gumstix/PKG900000001464/README.md

# Gumstix Raspberry Pi CM4 UprevAI
## PKG900000001464 

The **Gumstix Raspberry Pi CM4 UprevAI** replaces the CM3 compute module on compatible carrier boards, adding a CM4 connector and Google Coral TPU chip.
Accelerate your hardware and migrate it into the field of **Edge AI** without revising your design.

__Features Include__:
* Raspberry Pi CM3 compatible SODIMM edge connection
* Power indicator LED
* Google Coral G313-06329-00 TPU

__Links:__
* [AutoDoc Datasheet][autodoc]
* [Specifications][spec]
* [Store Page][store]
* [Schematics and Layout][hardware]

[thumbnail]: https://d3iwea566ns1n1.cloudfront.net/images/product/40edad650346ab020427c20a98565f45689e575a.png
[autodoc]: PKG900000001464_AutoDoc.pdf
[spec]: PKG900000001464_SpecSheet.pdf
[store]: https://store.gumstix.com/cm4-uprev-ai/
[hardware]: hardware/hardware.md
[firmware]: firmware/firmware.md
