gumstix/PKG900000001464/hardware/hardware.md

# Hardware

[Schematic PDF][pdf]
EAGLE [Schematic][sch] and [Layout][brd]

[pdf]: PKG900000001464.pdf
[brd]: PKG900000001464.brd
[sch]: PKG900000001464.sch
