gumstix/PKG900000001464/hardware/PKG900000001464.pdf

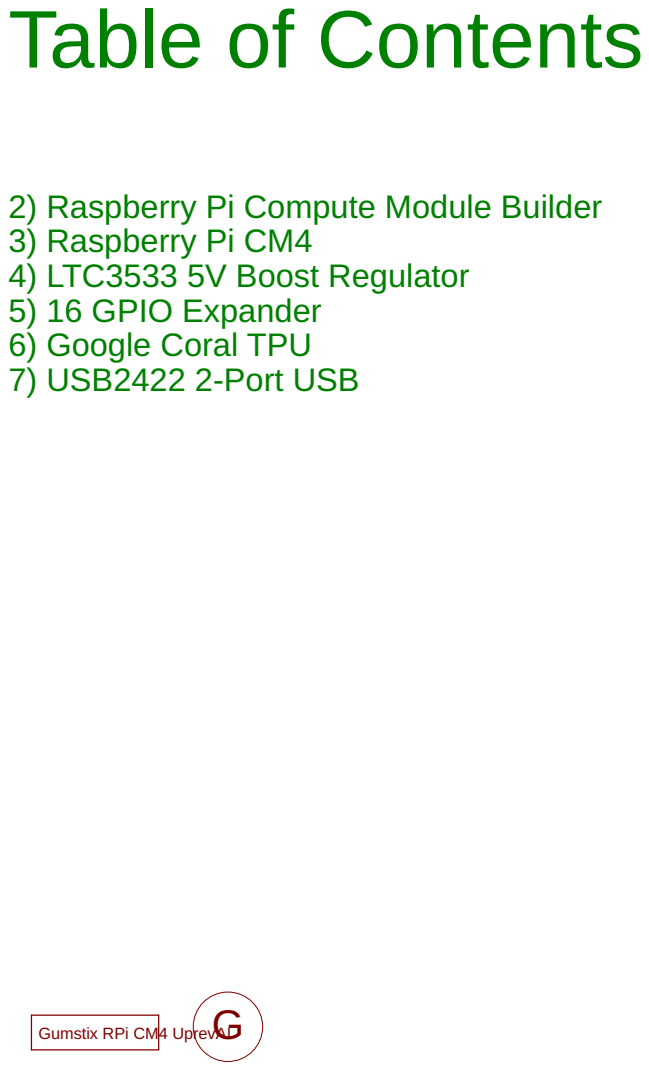
[picture p5: page 1]

2) Raspberry Pi Compute Module Builder
3) Raspberry Pi CM4
4) LTC3533 5V Boost Regulator
5) 16 GPIO Expander
6) Google Coral TPU
7) USB2422 2-Port USB

Gumstix Raspberry Pi CM4 UprevAI

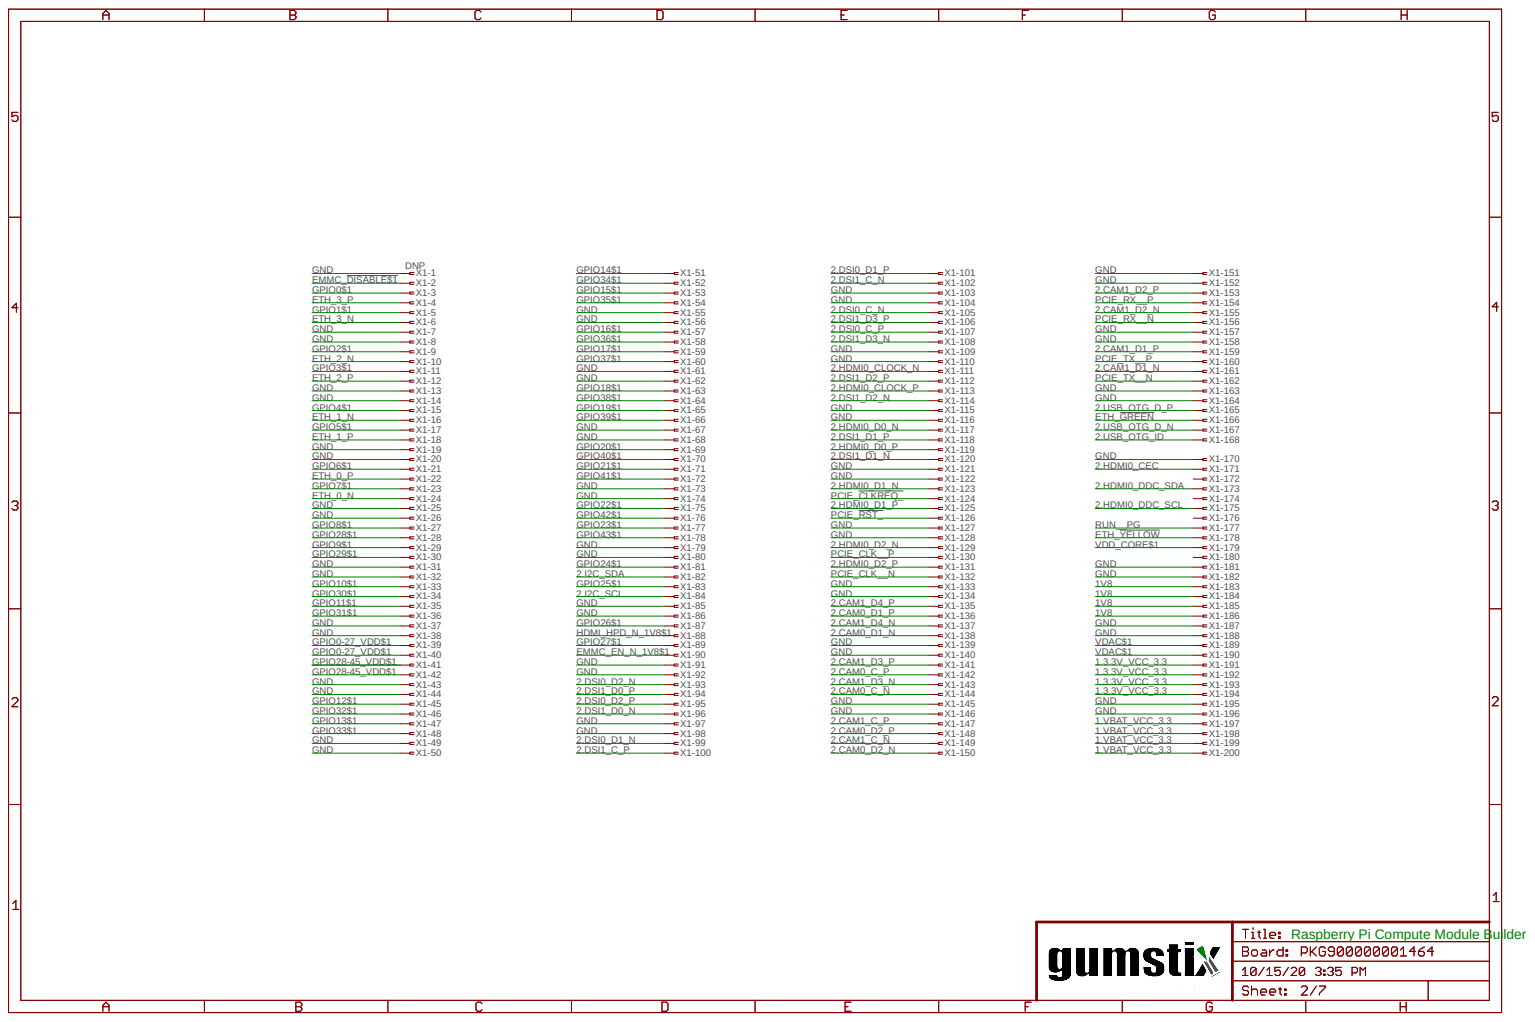
[picture p6: page 2]

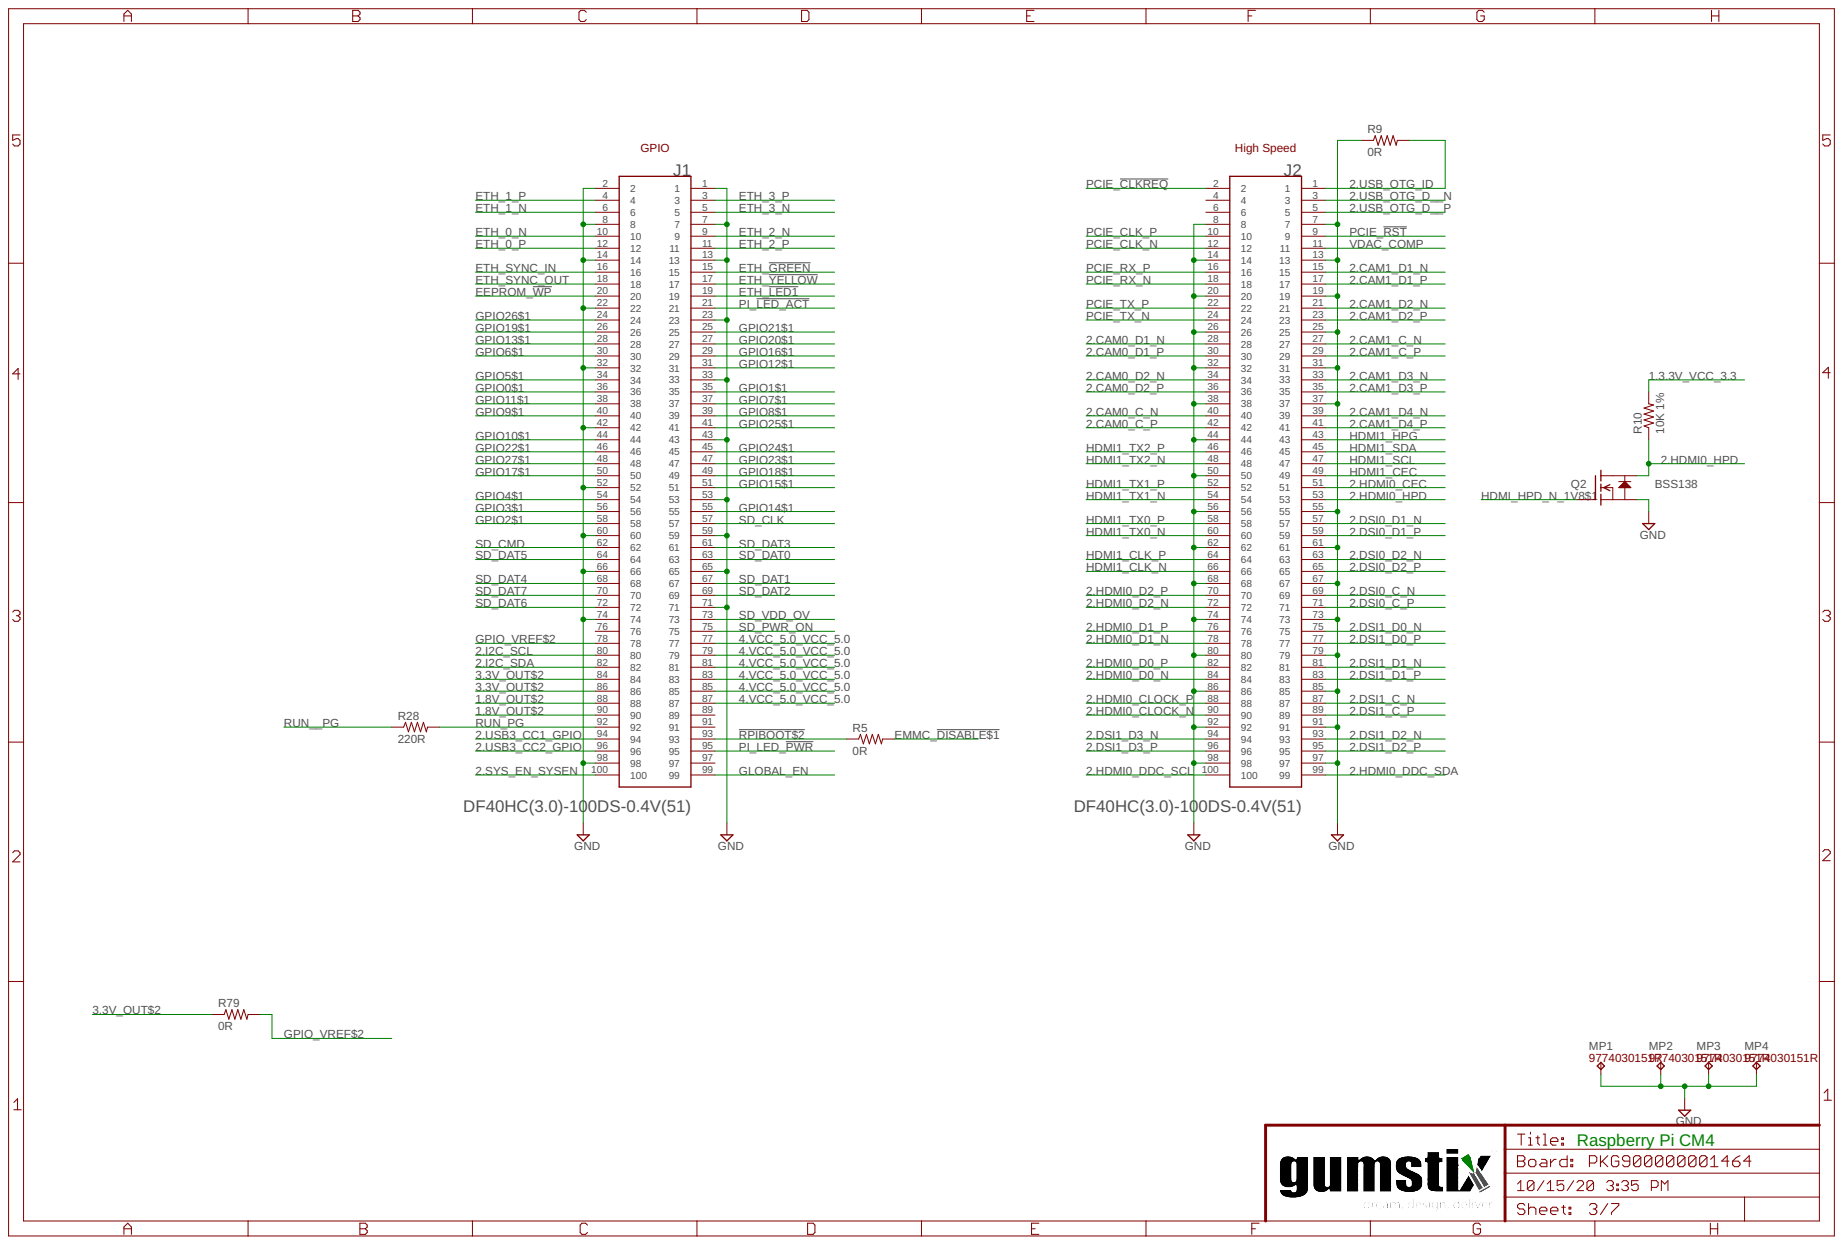
[picture p7: page 3]

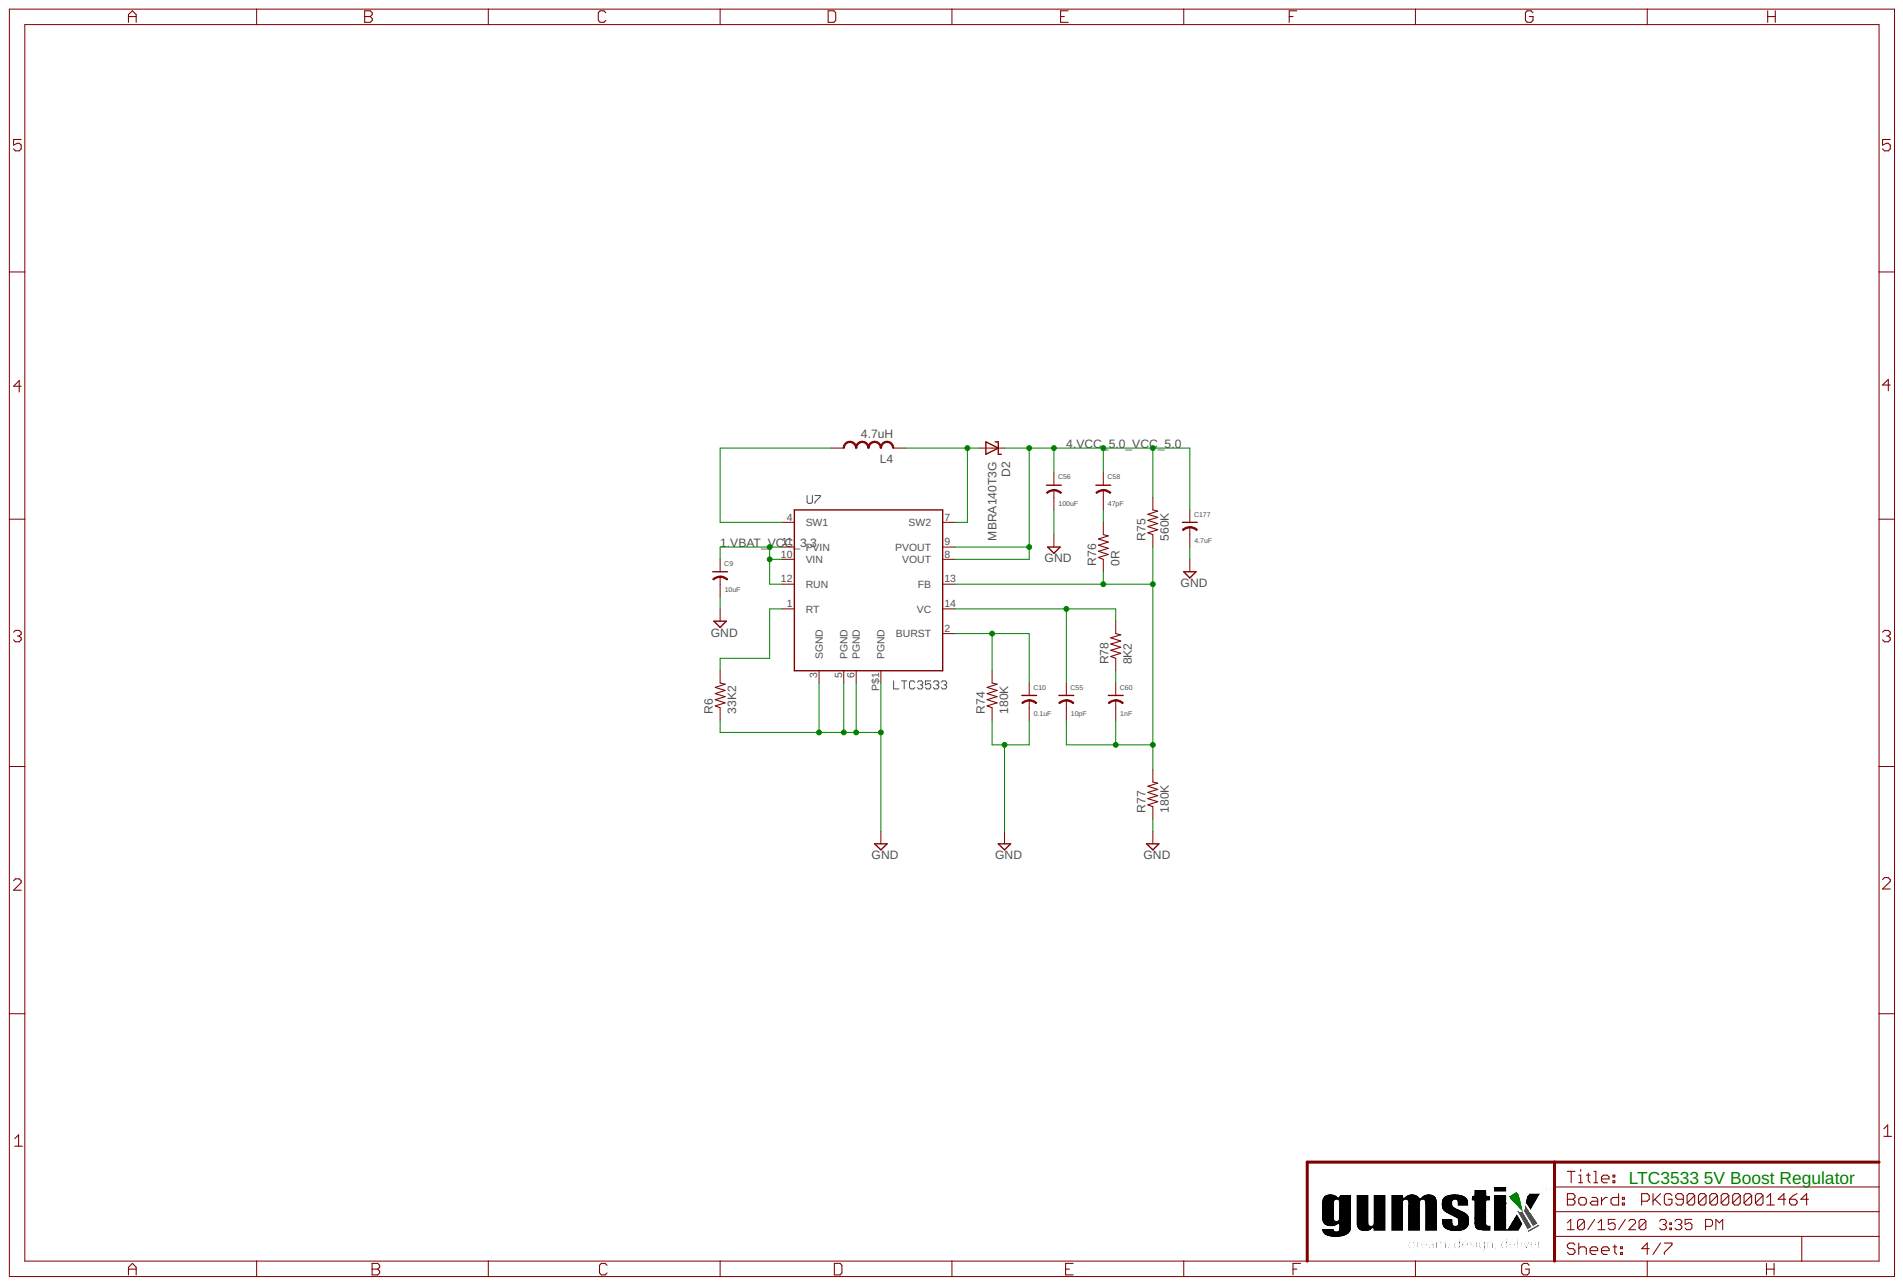
[picture p8: page 4]

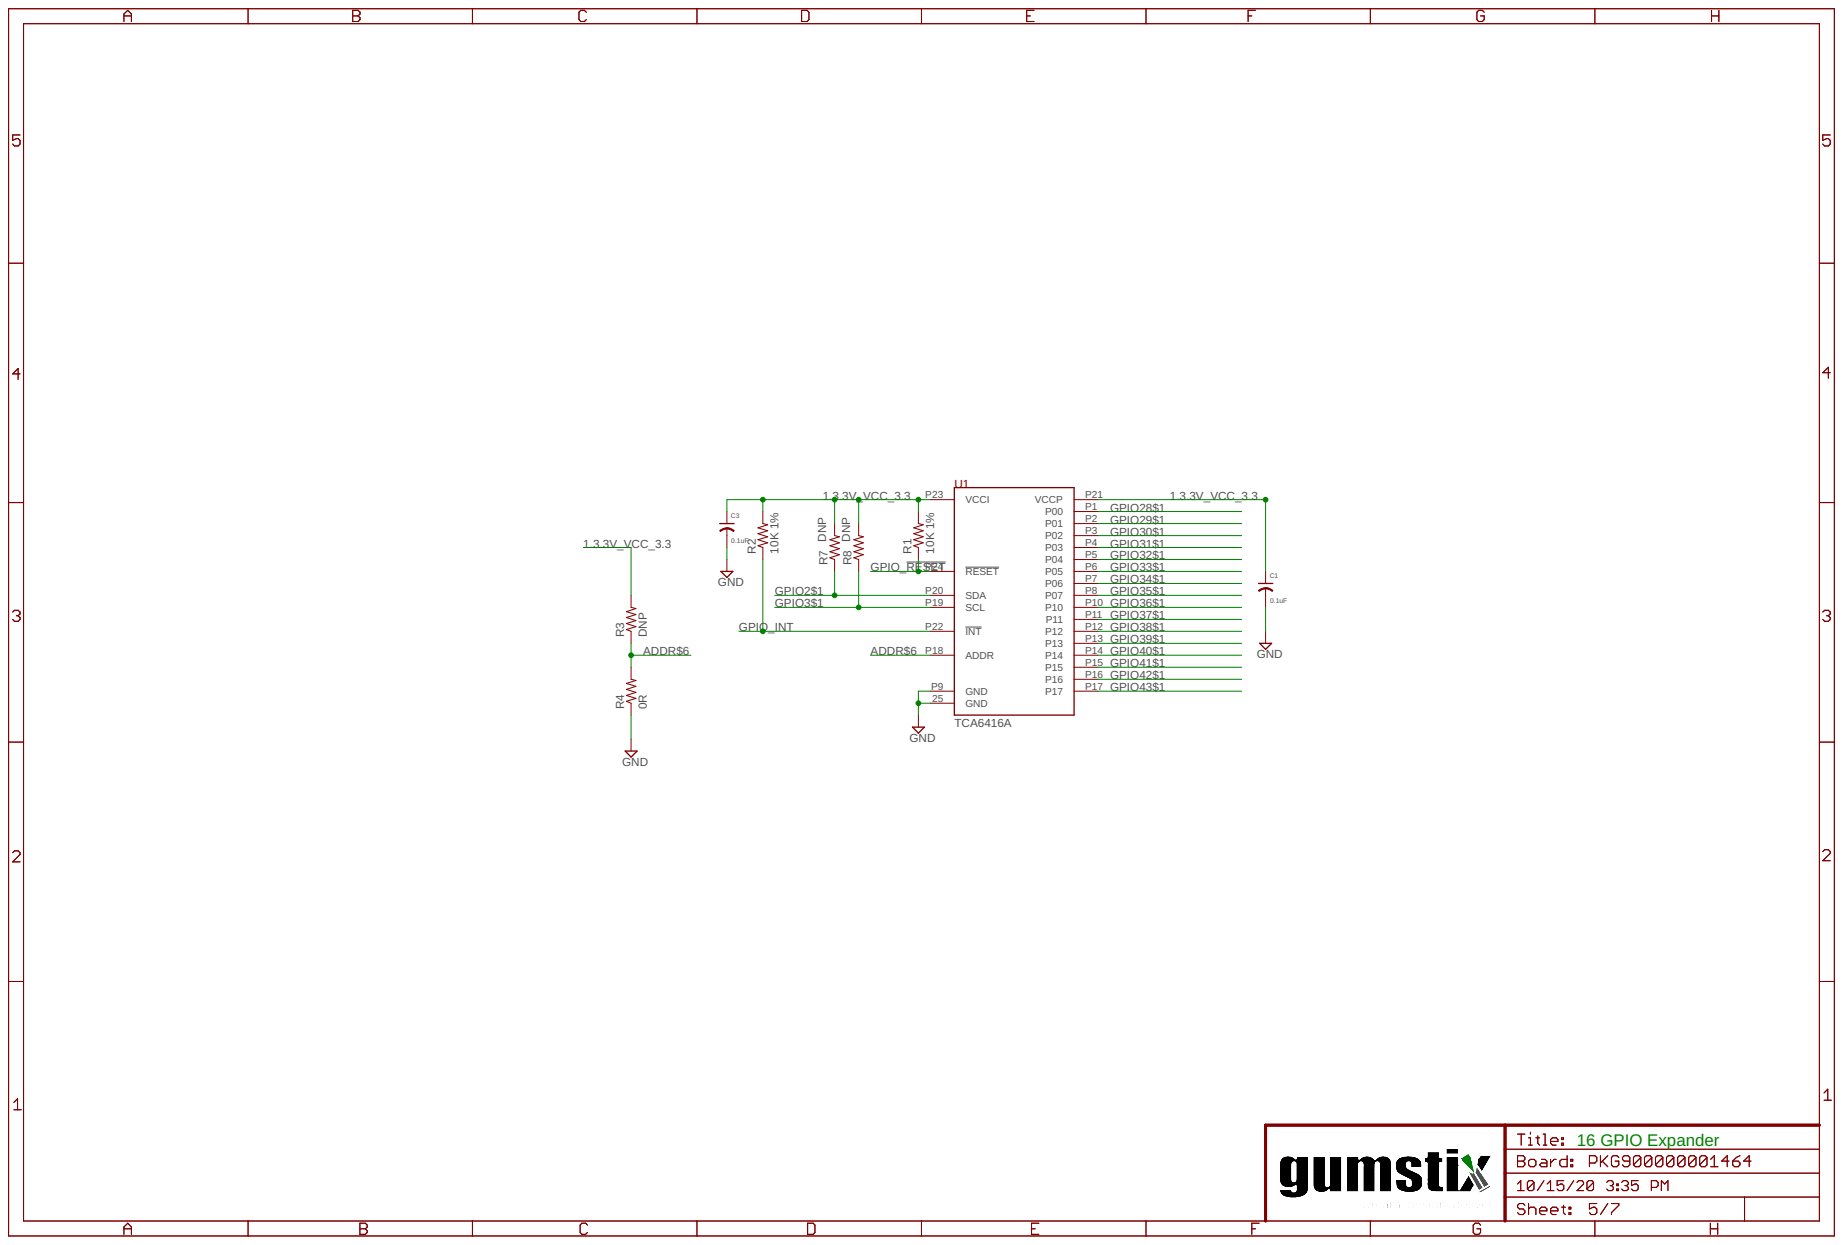
[picture p9: page 5]

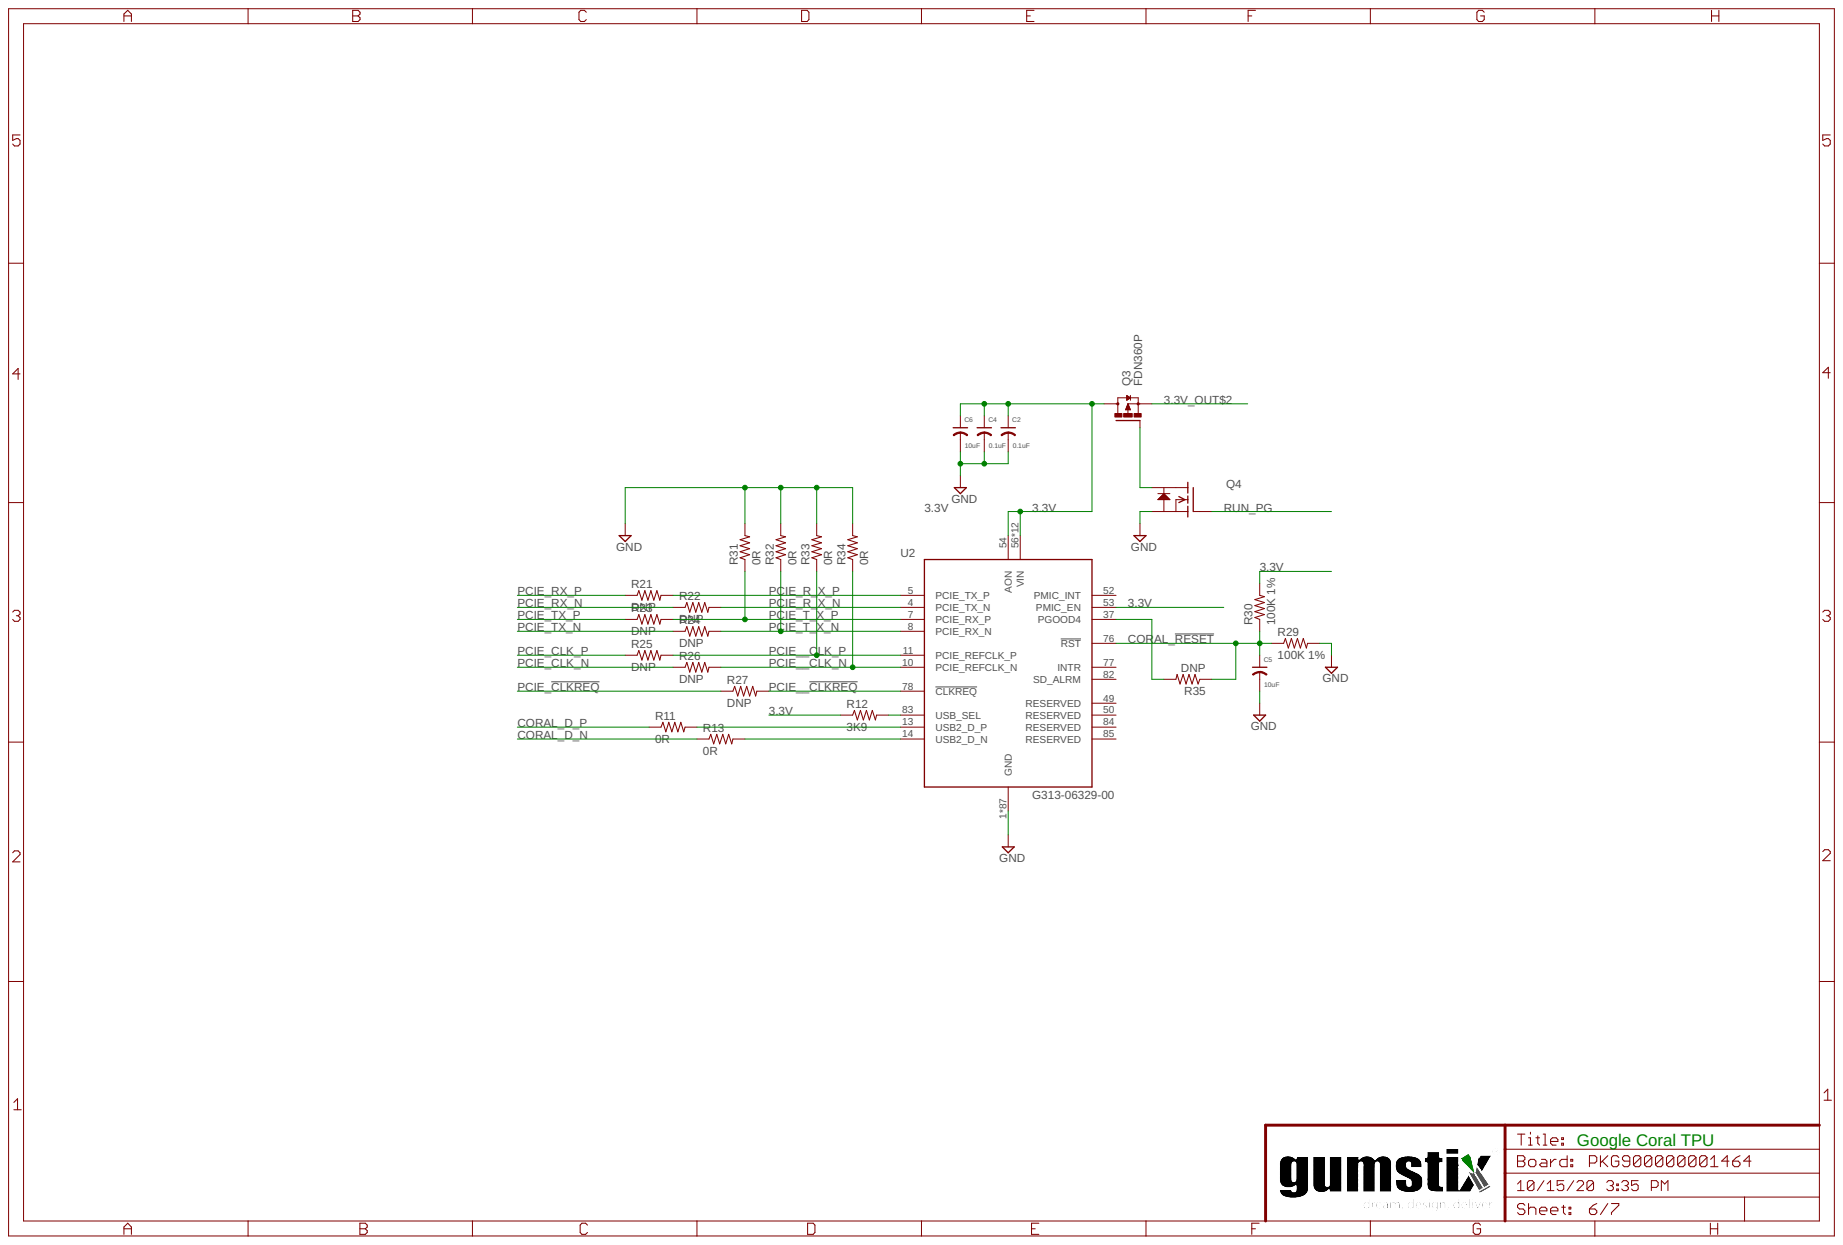
[picture p10: page 6]

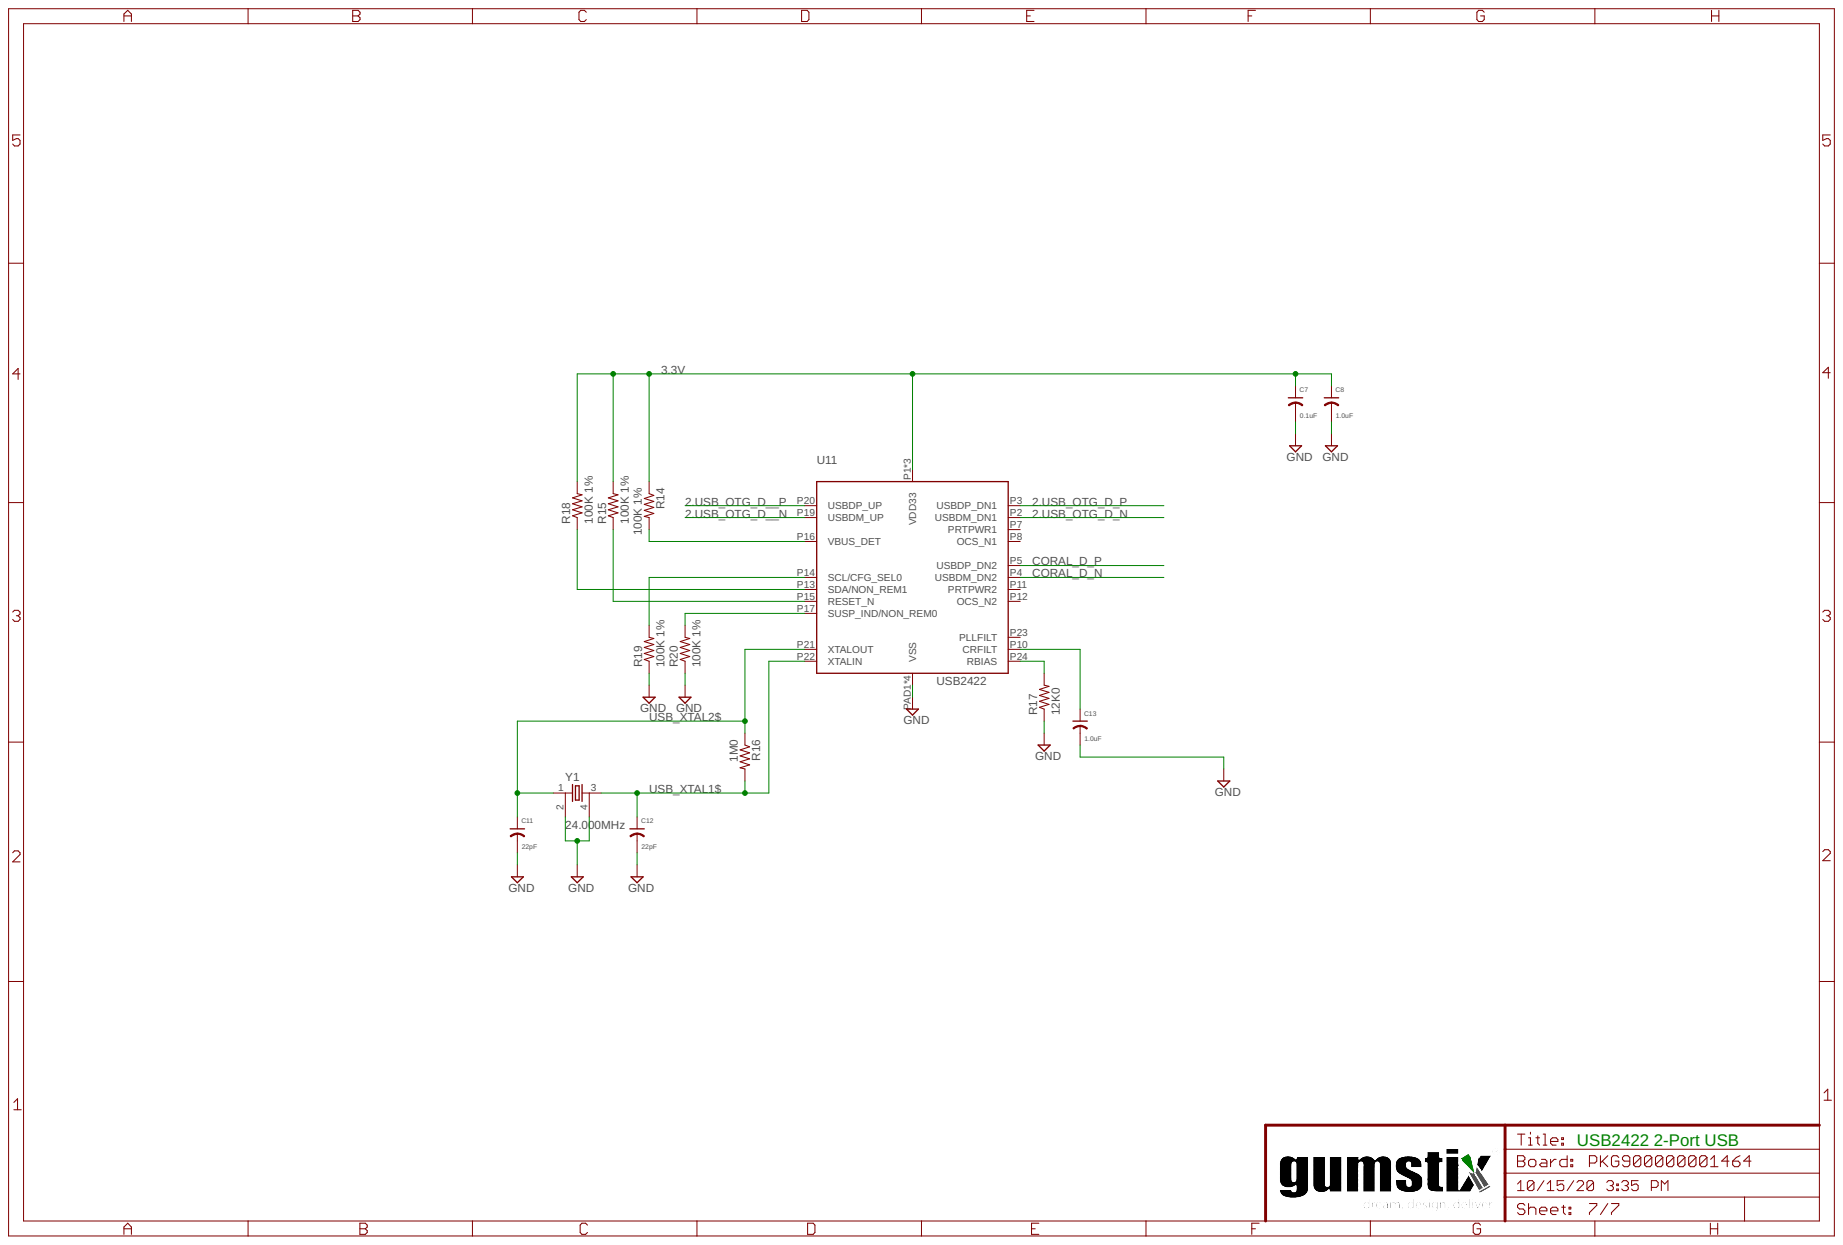
[picture p11: page 7]
