gumstix/PKG900000001464/hardware/PKG900000001464.brd

## EAGLE design hardware/PKG900000001464.brd (2020-10-15)

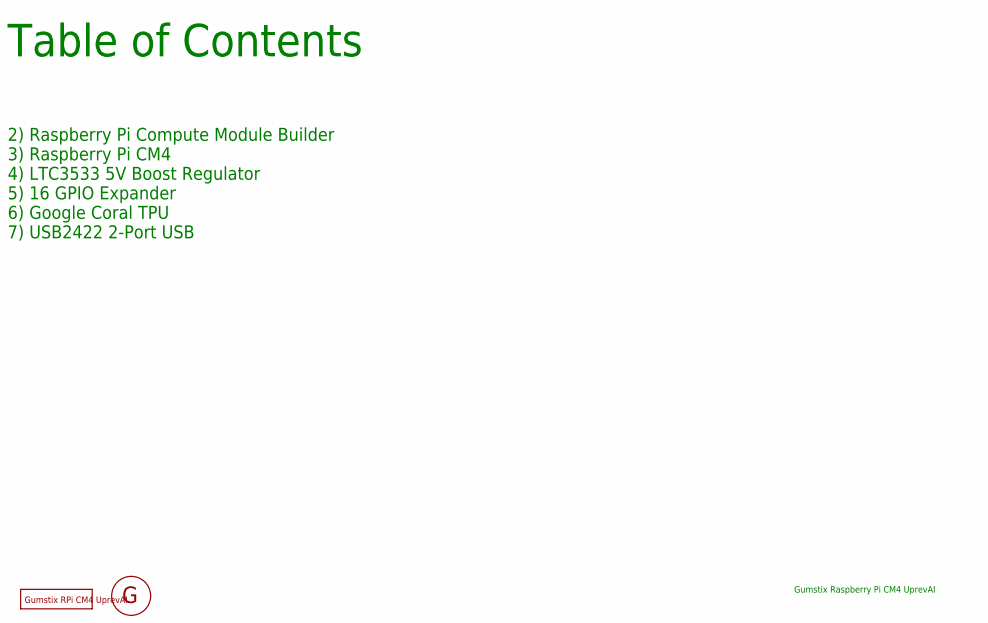
[picture p12: schematic PKG900000001464.sch, sheet 1]

Parts:
FD1, FD2, FD3, FD4, FD5, FD6: DNP; FIDUCIAL
U$3: DNP; GEPPETTO_LABEL
U$4: DNP; GEPPETTO_LOGO_SILK10

Notes on the sheet:
Table of Contents
Gumstix Raspberry Pi CM4 UprevAI
2) Raspberry Pi Compute Module Builder
3) Raspberry Pi CM4
4) LTC3533 5V Boost Regulator
5) 16 GPIO Expander
6) Google Coral TPU
7) USB2422 2-Port USB

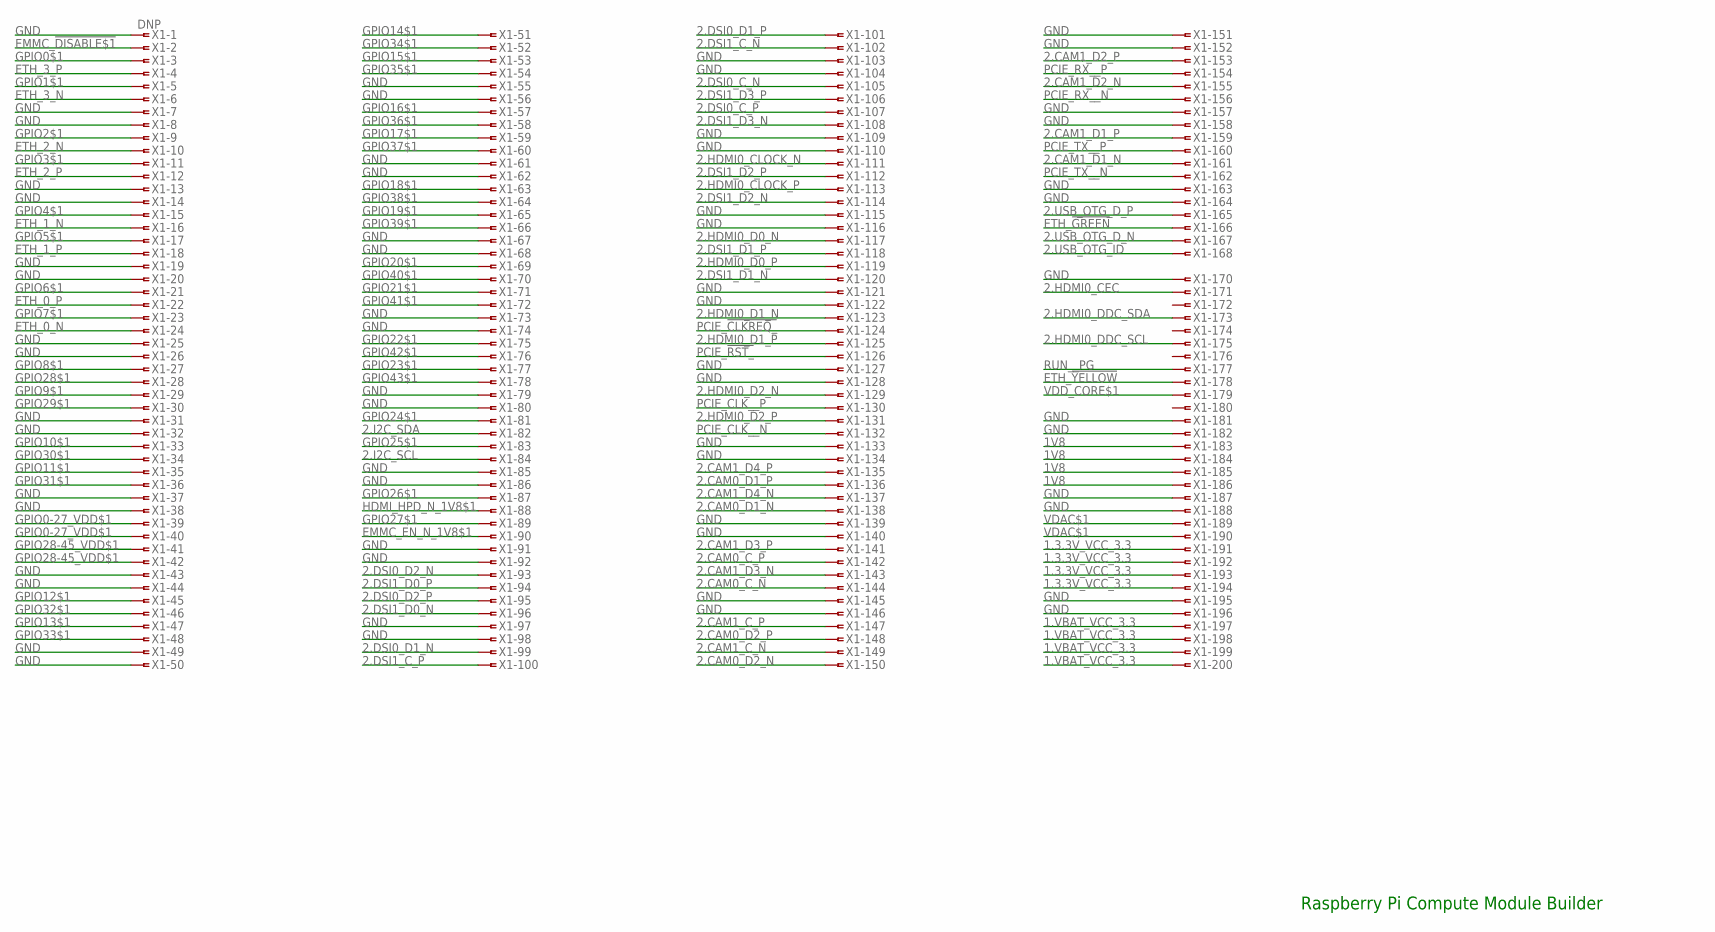
[picture p13: schematic PKG900000001464.sch, sheet 2]

Parts:
X1: DNP; SLOT-1376408-1_1.8V_MOD

Connections:
1.3.3V_VCC_3.3: X1.191, X1.192, X1.193, X1.194; also elsewhere on the board
1.VBAT_VCC_3.3: X1.197, X1.198, X1.199, X1.200; also elsewhere on the board
1V8: X1.183, X1.184, X1.185, X1.186
2.CAM0_C_N: X1.144; also elsewhere on the board
2.CAM0_C_P: X1.142; also elsewhere on the board
2.CAM0_D1_N: X1.138; also elsewhere on the board
2.CAM0_D1_P: X1.136; also elsewhere on the board
2.CAM0_D2_N: X1.150; also elsewhere on the board
2.CAM0_D2_P: X1.148; also elsewhere on the board
2.CAM1_C_N: X1.149; also elsewhere on the board
2.CAM1_C_P: X1.147; also elsewhere on the board
2.CAM1_D1_N: X1.161; also elsewhere on the board
2.CAM1_D1_P: X1.159; also elsewhere on the board
2.CAM1_D2_N: X1.155; also elsewhere on the board
2.CAM1_D2_P: X1.153; also elsewhere on the board
2.CAM1_D3_N: X1.143; also elsewhere on the board
2.CAM1_D3_P: X1.141; also elsewhere on the board
2.CAM1_D4_N: X1.137; also elsewhere on the board
2.CAM1_D4_P: X1.135; also elsewhere on the board
2.DSI0_C_N: X1.105; also elsewhere on the board
2.DSI0_C_P: X1.107; also elsewhere on the board
2.DSI0_D1_N: X1.99; also elsewhere on the board
2.DSI0_D1_P: X1.101; also elsewhere on the board
2.DSI0_D2_N: X1.93; also elsewhere on the board
2.DSI0_D2_P: X1.95; also elsewhere on the board
2.DSI1_C_N: X1.102; also elsewhere on the board
2.DSI1_C_P: X1.100; also elsewhere on the board
2.DSI1_D0_N: X1.96; also elsewhere on the board
2.DSI1_D0_P: X1.94; also elsewhere on the board
2.DSI1_D1_N: X1.120; also elsewhere on the board
2.DSI1_D1_P: X1.118; also elsewhere on the board
2.DSI1_D2_N: X1.114; also elsewhere on the board
2.DSI1_D2_P: X1.112; also elsewhere on the board
2.DSI1_D3_N: X1.108; also elsewhere on the board
2.DSI1_D3_P: X1.106; also elsewhere on the board
2.HDMI0_CEC: X1.171; also elsewhere on the board
2.HDMI0_CLOCK_N: X1.111; also elsewhere on the board
2.HDMI0_CLOCK_P: X1.113; also elsewhere on the board
2.HDMI0_D0_N: X1.117; also elsewhere on the board
2.HDMI0_D0_P: X1.119; also elsewhere on the board
2.HDMI0_D1_N: X1.123; also elsewhere on the board
2.HDMI0_D1_P: X1.125; also elsewhere on the board
2.HDMI0_D2_N: X1.129; also elsewhere on the board
2.HDMI0_D2_P: X1.131; also elsewhere on the board
2.HDMI0_DDC_SCL: X1.175; also elsewhere on the board
2.HDMI0_DDC_SDA: X1.173; also elsewhere on the board
2.I2C_SCL: X1.84; also elsewhere on the board
2.I2C_SDA: X1.82; also elsewhere on the board
2.USB_OTG_D_N: X1.167; also elsewhere on the board
2.USB_OTG_D_P: X1.165; also elsewhere on the board
2.USB_OTG_ID: X1.168; also elsewhere on the board
EMMC_!DISABLE$1: X1.2; also elsewhere on the board
EMMC_EN_N_1V8$1: X1.90
ETH_0_N: X1.24; also elsewhere on the board
ETH_0_P: X1.22; also elsewhere on the board
ETH_1_N: X1.16; also elsewhere on the board
ETH_1_P: X1.18; also elsewhere on the board
ETH_2_N: X1.10; also elsewhere on the board
ETH_2_P: X1.12; also elsewhere on the board
ETH_3_N: X1.6; also elsewhere on the board
ETH_3_P: X1.4; also elsewhere on the board
ETH_!GREEN: X1.166; also elsewhere on the board
ETH_!YELLOW: X1.178; also elsewhere on the board
GND: X1.1, X1.7, X1.8, X1.13, X1.14, X1.19, X1.20, X1.25, X1.26, X1.31, X1.32, X1.37, X1.38, X1.43, X1.44, X1.49, X1.50, X1.55, X1.56, X1.61, X1.62, X1.67, X1.68, X1.73, X1.74, X1.79, X1.80, X1.85, X1.86, X1.91, X1.92, X1.97, X1.98, X1.103, X1.104, X1.109, X1.110, X1.115, X1.116, X1.121, X1.122, X1.127, X1.128, X1.133, X1.134, X1.139, X1.140, X1.145, X1.146, X1.151, X1.152, X1.157, X1.158, X1.163, X1.164, X1.170, X1.181, X1.182, X1.187, X1.188, X1.195, X1.196; also elsewhere on the board
GPIO0$1: X1.3; also elsewhere on the board
GPIO0-27_VDD$1: X1.39, X1.40
GPIO1$1: X1.5; also elsewhere on the board
GPIO2$1: X1.9; also elsewhere on the board
GPIO3$1: X1.11; also elsewhere on the board
GPIO4$1: X1.15; also elsewhere on the board
GPIO5$1: X1.17; also elsewhere on the board
GPIO6$1: X1.21; also elsewhere on the board
GPIO7$1: X1.23; also elsewhere on the board
GPIO8$1: X1.27; also elsewhere on the board
GPIO9$1: X1.29; also elsewhere on the board
GPIO10$1: X1.33; also elsewhere on the board
GPIO11$1: X1.35; also elsewhere on the board
GPIO12$1: X1.45; also elsewhere on the board
GPIO13$1: X1.47; also elsewhere on the board
GPIO14$1: X1.51; also elsewhere on the board
GPIO15$1: X1.53; also elsewhere on the board
GPIO16$1: X1.57; also elsewhere on the board
GPIO17$1: X1.59; also elsewhere on the board
GPIO18$1: X1.63; also elsewhere on the board
GPIO19$1: X1.65; also elsewhere on the board
GPIO20$1: X1.69; also elsewhere on the board
GPIO21$1: X1.71; also elsewhere on the board
GPIO22$1: X1.75; also elsewhere on the board
GPIO23$1: X1.77; also elsewhere on the board
GPIO24$1: X1.81; also elsewhere on the board
GPIO25$1: X1.83; also elsewhere on the board
GPIO26$1: X1.87; also elsewhere on the board
GPIO27$1: X1.89; also elsewhere on the board
GPIO28$1: X1.28; also elsewhere on the board
GPIO28-45_VDD$1: X1.41, X1.42
GPIO29$1: X1.30; also elsewhere on the board
GPIO30$1: X1.34; also elsewhere on the board
GPIO31$1: X1.36; also elsewhere on the board
GPIO32$1: X1.46; also elsewhere on the board
GPIO33$1: X1.48; also elsewhere on the board
GPIO34$1: X1.52; also elsewhere on the board
GPIO35$1: X1.54; also elsewhere on the board
GPIO36$1: X1.58; also elsewhere on the board
GPIO37$1: X1.60; also elsewhere on the board
GPIO38$1: X1.64; also elsewhere on the board
GPIO39$1: X1.66; also elsewhere on the board
GPIO40$1: X1.70; also elsewhere on the board
GPIO41$1: X1.72; also elsewhere on the board
GPIO42$1: X1.76; also elsewhere on the board
GPIO43$1: X1.78; also elsewhere on the board
HDMI_HPD_N_1V8$1: X1.88; also elsewhere on the board
PCIE_!CLKREQ_: X1.124
PCIE_!RST_: X1.126
PCIE_CLK__N: X1.132
PCIE_CLK__P: X1.130
PCIE_RX__N: X1.156
PCIE_RX__P: X1.154
PCIE_TX__N: X1.162
PCIE_TX__P: X1.160
RUN__PG: X1.177; also elsewhere on the board
VDAC$1: X1.189, X1.190
VDD_CORE$1: X1.179

Notes on the sheet:
Raspberry Pi Compute Module Builder

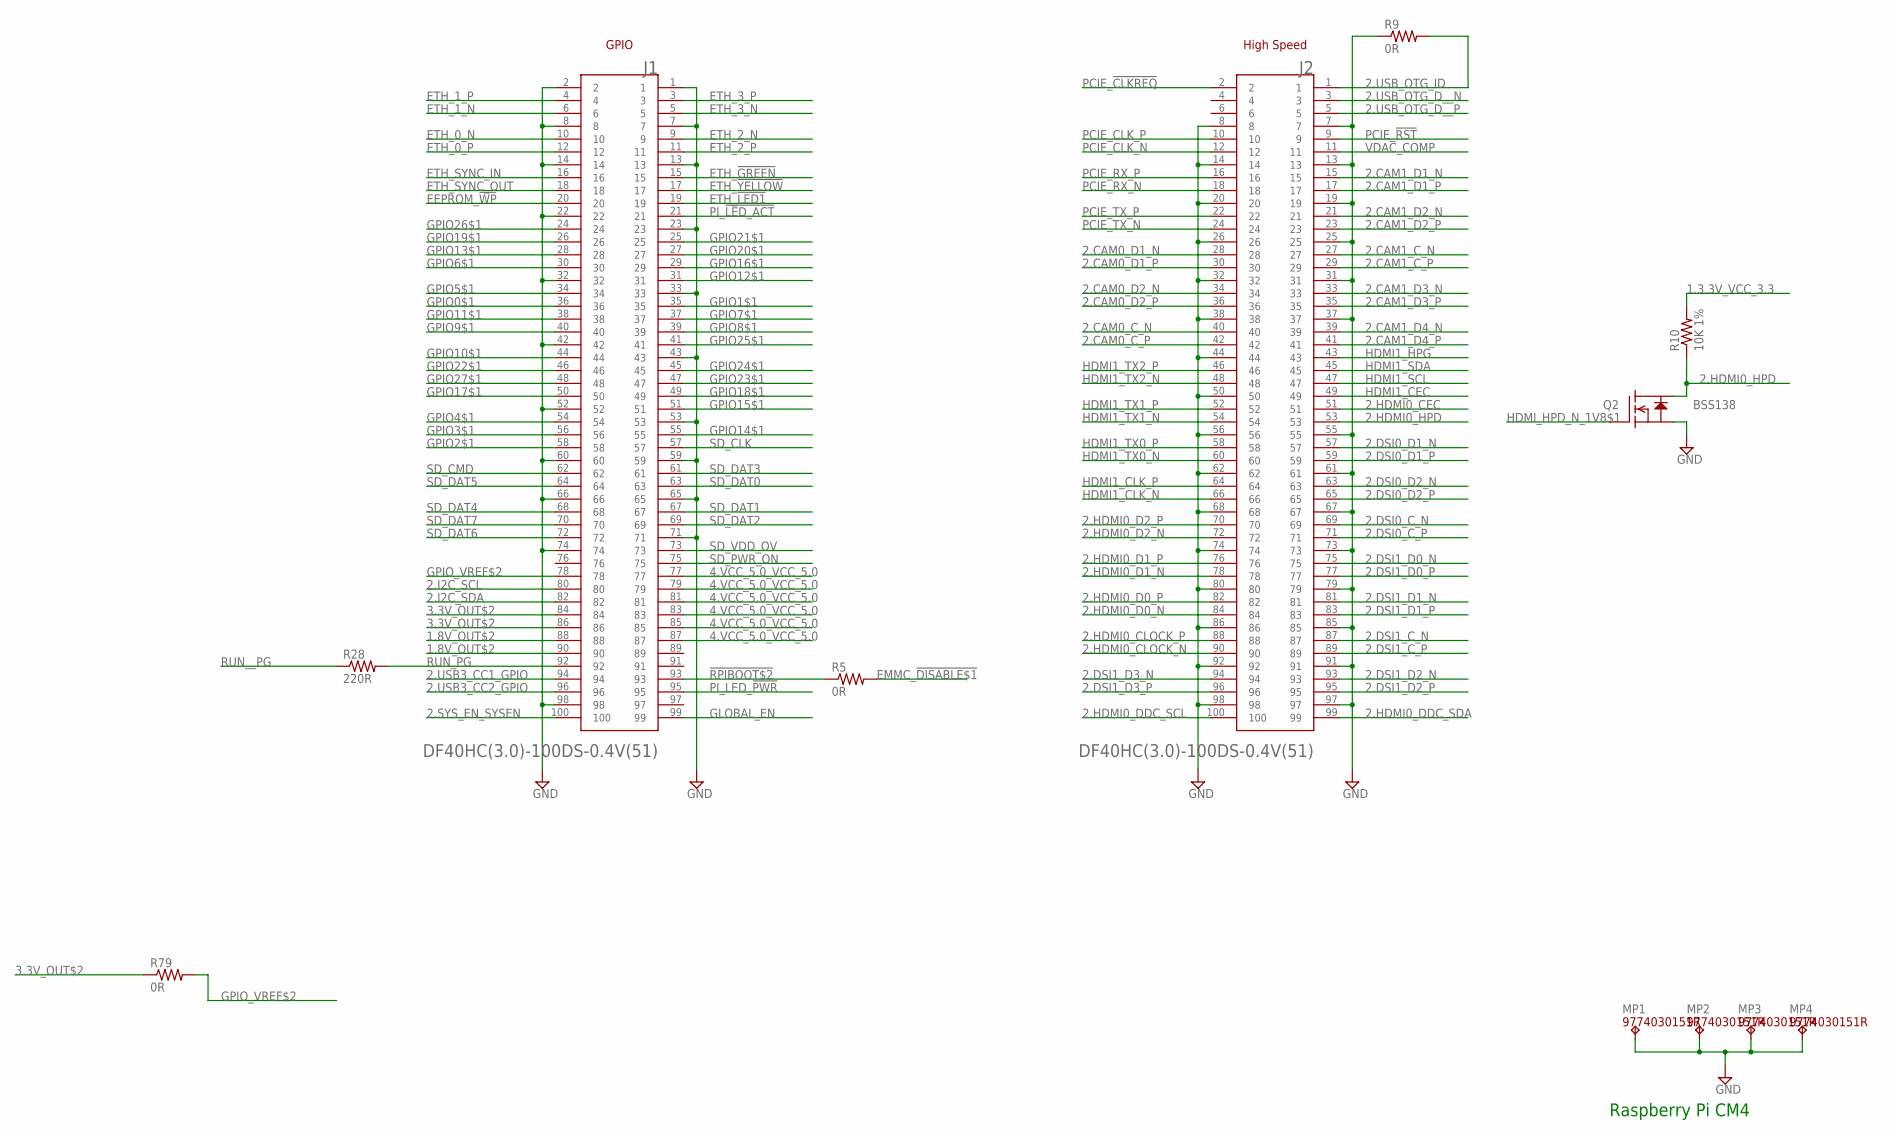
[picture p14: schematic PKG900000001464.sch, sheet 3]

Parts:
J1, J2: DF40HC(3.0)-100DS-0.4V(51); HRS_DF40C-100DS-0.4V(51)
MP1, MP2, MP3, MP4: 9774030151R; WA-SMSI_9774___151
Q2: BSS138; SOT23
R5, R9, R79: 0R; 0201
R10: 10K 1%; 0201
R28: 220R; 0402

Connections:
1.3.3V_VCC_3.3: R10.2; also elsewhere on the board
1.8V_OUT$2: J1.88, J1.90
2.CAM0_C_N: J2.40; also elsewhere on the board
2.CAM0_C_P: J2.42; also elsewhere on the board
2.CAM0_D1_N: J2.28; also elsewhere on the board
2.CAM0_D1_P: J2.30; also elsewhere on the board
2.CAM0_D2_N: J2.34; also elsewhere on the board
2.CAM0_D2_P: J2.36; also elsewhere on the board
2.CAM1_C_N: J2.27; also elsewhere on the board
2.CAM1_C_P: J2.29; also elsewhere on the board
2.CAM1_D1_N: J2.15; also elsewhere on the board
2.CAM1_D1_P: J2.17; also elsewhere on the board
2.CAM1_D2_N: J2.21; also elsewhere on the board
2.CAM1_D2_P: J2.23; also elsewhere on the board
2.CAM1_D3_N: J2.33; also elsewhere on the board
2.CAM1_D3_P: J2.35; also elsewhere on the board
2.CAM1_D4_N: J2.39; also elsewhere on the board
2.CAM1_D4_P: J2.41; also elsewhere on the board
2.DSI0_C_N: J2.69; also elsewhere on the board
2.DSI0_C_P: J2.71; also elsewhere on the board
2.DSI0_D1_N: J2.57; also elsewhere on the board
2.DSI0_D1_P: J2.59; also elsewhere on the board
2.DSI0_D2_N: J2.63; also elsewhere on the board
2.DSI0_D2_P: J2.65; also elsewhere on the board
2.DSI1_C_N: J2.87; also elsewhere on the board
2.DSI1_C_P: J2.89; also elsewhere on the board
2.DSI1_D0_N: J2.75; also elsewhere on the board
2.DSI1_D0_P: J2.77; also elsewhere on the board
2.DSI1_D1_N: J2.81; also elsewhere on the board
2.DSI1_D1_P: J2.83; also elsewhere on the board
2.DSI1_D2_N: J2.93; also elsewhere on the board
2.DSI1_D2_P: J2.95; also elsewhere on the board
2.DSI1_D3_N: J2.94; also elsewhere on the board
2.DSI1_D3_P: J2.96; also elsewhere on the board
2.HDMI0_CEC: J2.51; also elsewhere on the board
2.HDMI0_CLOCK_N: J2.90; also elsewhere on the board
2.HDMI0_CLOCK_P: J2.88; also elsewhere on the board
2.HDMI0_D0_N: J2.84; also elsewhere on the board
2.HDMI0_D0_P: J2.82; also elsewhere on the board
2.HDMI0_D1_N: J2.78; also elsewhere on the board
2.HDMI0_D1_P: J2.76; also elsewhere on the board
2.HDMI0_D2_N: J2.72; also elsewhere on the board
2.HDMI0_D2_P: J2.70; also elsewhere on the board
2.HDMI0_DDC_SCL: J2.100; also elsewhere on the board
2.HDMI0_DDC_SDA: J2.99; also elsewhere on the board
2.HDMI0_HPD: J2.53, Q2.3 (D), R10.1
2.I2C_SCL: J1.80; also elsewhere on the board
2.I2C_SDA: J1.82; also elsewhere on the board
2.SYS_EN_SYSEN: J1.100
2.USB3_CC1_GPIO: J1.94
2.USB3_CC2_GPIO: J1.96
2.USB_OTG_D__N: J2.3; also elsewhere on the board
2.USB_OTG_D__P: J2.5; also elsewhere on the board
2.USB_OTG_ID: J2.1, R9.2; also elsewhere on the board
3.3V_OUT$2: J1.84, J1.86, R79.1; also elsewhere on the board
4.VCC_5.0_VCC_5.0: J1.77, J1.79, J1.81, J1.83, J1.85, J1.87; also elsewhere on the board
!RPIBOOT$2: J1.93, R5.1
EEPROM_!WP: J1.20
EMMC_!DISABLE$1: R5.2; also elsewhere on the board
ETH_0_N: J1.10; also elsewhere on the board
ETH_0_P: J1.12; also elsewhere on the board
ETH_1_N: J1.6; also elsewhere on the board
ETH_1_P: J1.4; also elsewhere on the board
ETH_2_N: J1.9; also elsewhere on the board
ETH_2_P: J1.11; also elsewhere on the board
ETH_3_N: J1.5; also elsewhere on the board
ETH_3_P: J1.3; also elsewhere on the board
ETH_!GREEN: J1.15; also elsewhere on the board
ETH_!LED1: J1.19
ETH_!YELLOW: J1.17; also elsewhere on the board
ETH_SYNC_IN: J1.16
ETH_SYNC_OUT: J1.18
GLOBAL_EN: J1.99
GND: J1.1, J1.2, J1.7, J1.8, J1.13, J1.14, J1.22, J1.23, J1.32, J1.33, J1.42, J1.43, J1.52, J1.53, J1.59, J1.60, J1.65, J1.66, J1.71, J1.74, J1.98, J2.7, J2.8, J2.13, J2.14, J2.19, J2.20, J2.25, J2.26, J2.31, J2.32, J2.37, J2.38, J2.44, J2.50, J2.55, J2.56, J2.61, J2.62, J2.67, J2.68, J2.73, J2.74, J2.79, J2.80, J2.85, J2.86, J2.91, J2.92, J2.97, J2.98, MP1.1, MP2.1, MP3.1, MP4.1, Q2.2 (S), R9.1; also elsewhere on the board
GPIO0$1: J1.36; also elsewhere on the board
GPIO1$1: J1.35; also elsewhere on the board
GPIO2$1: J1.58; also elsewhere on the board
GPIO3$1: J1.56; also elsewhere on the board
GPIO4$1: J1.54; also elsewhere on the board
GPIO5$1: J1.34; also elsewhere on the board
GPIO6$1: J1.30; also elsewhere on the board
GPIO7$1: J1.37; also elsewhere on the board
GPIO8$1: J1.39; also elsewhere on the board
GPIO9$1: J1.40; also elsewhere on the board
GPIO10$1: J1.44; also elsewhere on the board
GPIO11$1: J1.38; also elsewhere on the board
GPIO12$1: J1.31; also elsewhere on the board
GPIO13$1: J1.28; also elsewhere on the board
GPIO14$1: J1.55; also elsewhere on the board
GPIO15$1: J1.51; also elsewhere on the board
GPIO16$1: J1.29; also elsewhere on the board
GPIO17$1: J1.50; also elsewhere on the board
GPIO18$1: J1.49; also elsewhere on the board
GPIO19$1: J1.26; also elsewhere on the board
GPIO20$1: J1.27; also elsewhere on the board
GPIO21$1: J1.25; also elsewhere on the board
GPIO22$1: J1.46; also elsewhere on the board
GPIO23$1: J1.47; also elsewhere on the board
GPIO24$1: J1.45; also elsewhere on the board
GPIO25$1: J1.41; also elsewhere on the board
GPIO26$1: J1.24; also elsewhere on the board
GPIO27$1: J1.48; also elsewhere on the board
GPIO_VREF$2: J1.78, R79.2
HDMI1_CEC: J2.49
HDMI1_CLK_N: J2.66
HDMI1_CLK_P: J2.64
HDMI1_HPG: J2.43
HDMI1_SCL: J2.47
HDMI1_SDA: J2.45
HDMI1_TX0_N: J2.60
HDMI1_TX0_P: J2.58
HDMI1_TX1_N: J2.54
HDMI1_TX1_P: J2.52
HDMI1_TX2_N: J2.48
HDMI1_TX2_P: J2.46
HDMI_HPD_N_1V8$1: Q2.1 (G); also elsewhere on the board
PCIE_!CLKREQ: J2.2; also elsewhere on the board
PCIE_!RST: J2.9
PCIE_CLK_N: J2.12; also elsewhere on the board
PCIE_CLK_P: J2.10; also elsewhere on the board
PCIE_RX_N: J2.18; also elsewhere on the board
PCIE_RX_P: J2.16; also elsewhere on the board
PCIE_TX_N: J2.24; also elsewhere on the board
PCIE_TX_P: J2.22; also elsewhere on the board
PI_!LED_ACT: J1.21
PI_LED_!PWR: J1.95
RUN_PG: J1.92, R28.2; also elsewhere on the board
RUN__PG: R28.1; also elsewhere on the board
SD_CLK: J1.57
SD_CMD: J1.62
SD_DAT0: J1.63
SD_DAT1: J1.67
SD_DAT2: J1.69
SD_DAT3: J1.61
SD_DAT4: J1.68
SD_DAT5: J1.64
SD_DAT6: J1.72
SD_DAT7: J1.70
SD_PWR_ON: J1.75
SD_VDD_OV: J1.73
VDAC_COMP: J2.11

Notes on the sheet:
Raspberry Pi CM4
GPIO
High Speed

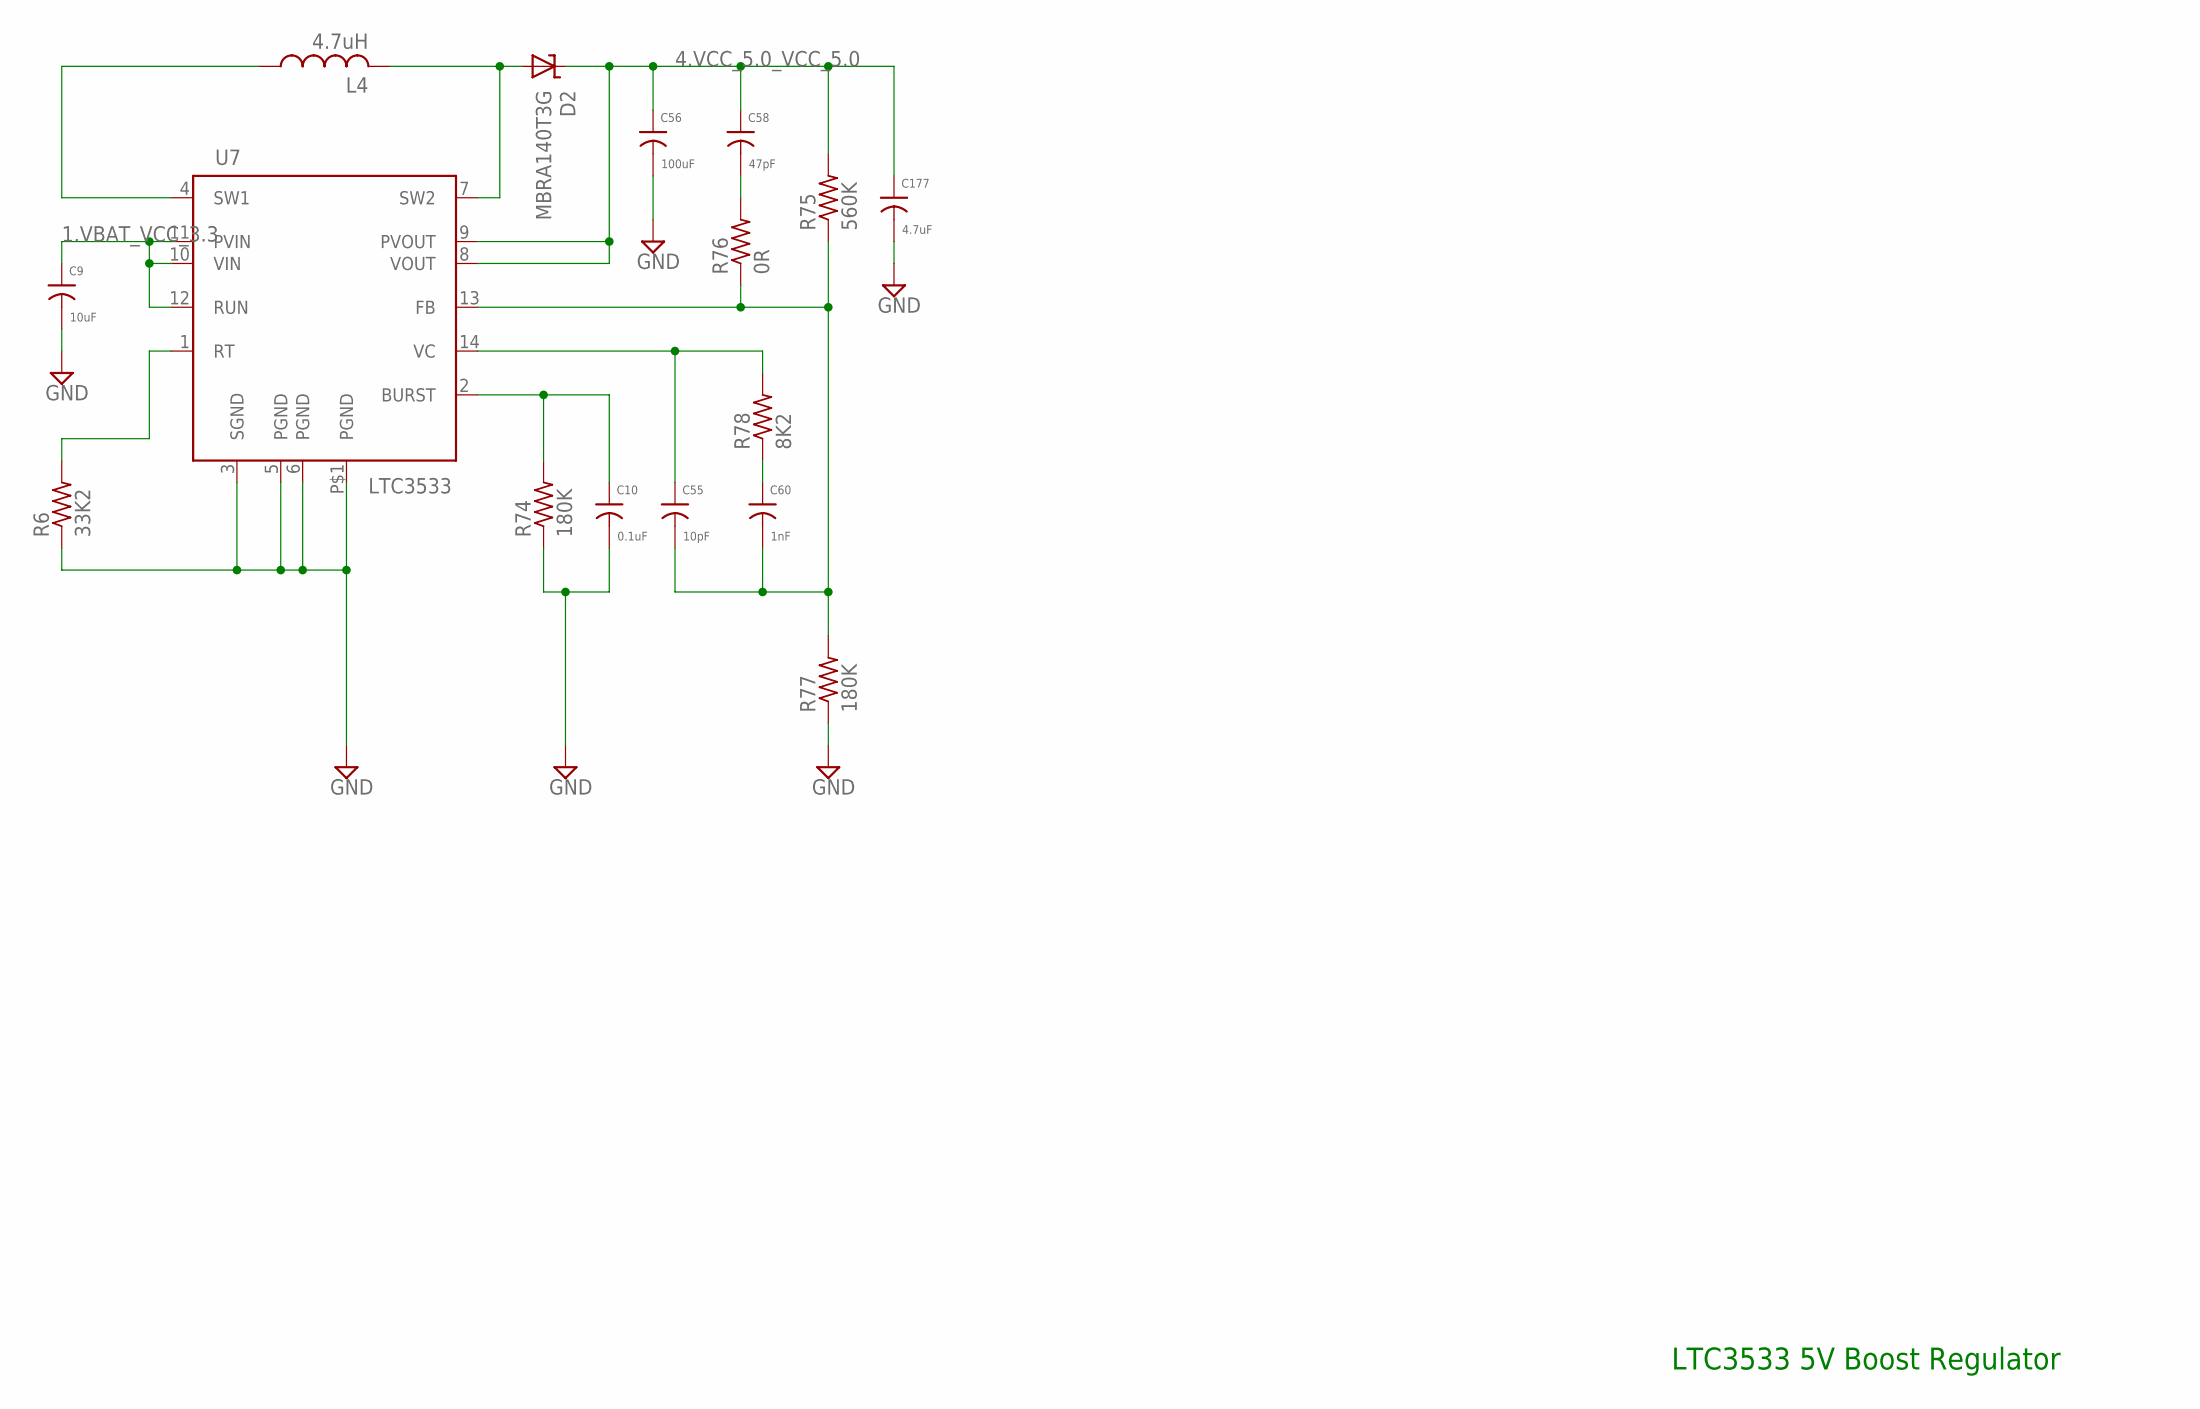
[picture p15: schematic PKG900000001464.sch, sheet 4]

Parts:
C9: 10uF; 0603
C10: 0.1uF; 0201
C55: 10pF; 0201
C56: 100uF; 1206
C58: 47pF; 0201
C60: 1nF; 0402
C177: 4.7uF; 0603
D2: MBRA140T3G; SMAJ
L4: 4.7uH; B82462
R6: 33K2; 0402
R74, R77: 180K; 0201
R75: 560K; 0402
R76: 0R; 0201
R78: 8K2; 0402
U7: LTC3533; DFN-14

Connections:
1.VBAT_VCC_3.3: C9.1, U7.10 (VIN), U7.11 (PVIN), U7.12 (RUN); also elsewhere on the board
4.VCC_5.0_VCC_5.0: C56.1, C58.1, C177.1, D2.C, R75.2, U7.8 (VOUT), U7.9 (PVOUT); also elsewhere on the board
BURST$3: C10.1, R74.2, U7.2 (BURST)
FB_5$3: C55.2, C60.2, R75.1, R76.1, R77.2, U7.13 (FB)
FB_5A$3: C58.2, R76.2
GND: C9.2, C10.2, C56.2, C177.2, R6.1, R74.1, R77.1, U7.3 (SGND), U7.5 (PGND), U7.6 (PGND), U7.P$1 (PGND); also elsewhere on the board
PRE_FB$3: C60.1, R78.1
RT$3: R6.2, U7.1 (RT)
SW1$3: L4.1, U7.4 (SW1)
SW2$3: D2.A, L4.2, U7.7 (SW2)
VC$3: C55.1, R78.2, U7.14 (VC)

Notes on the sheet:
LTC3533 5V Boost Regulator

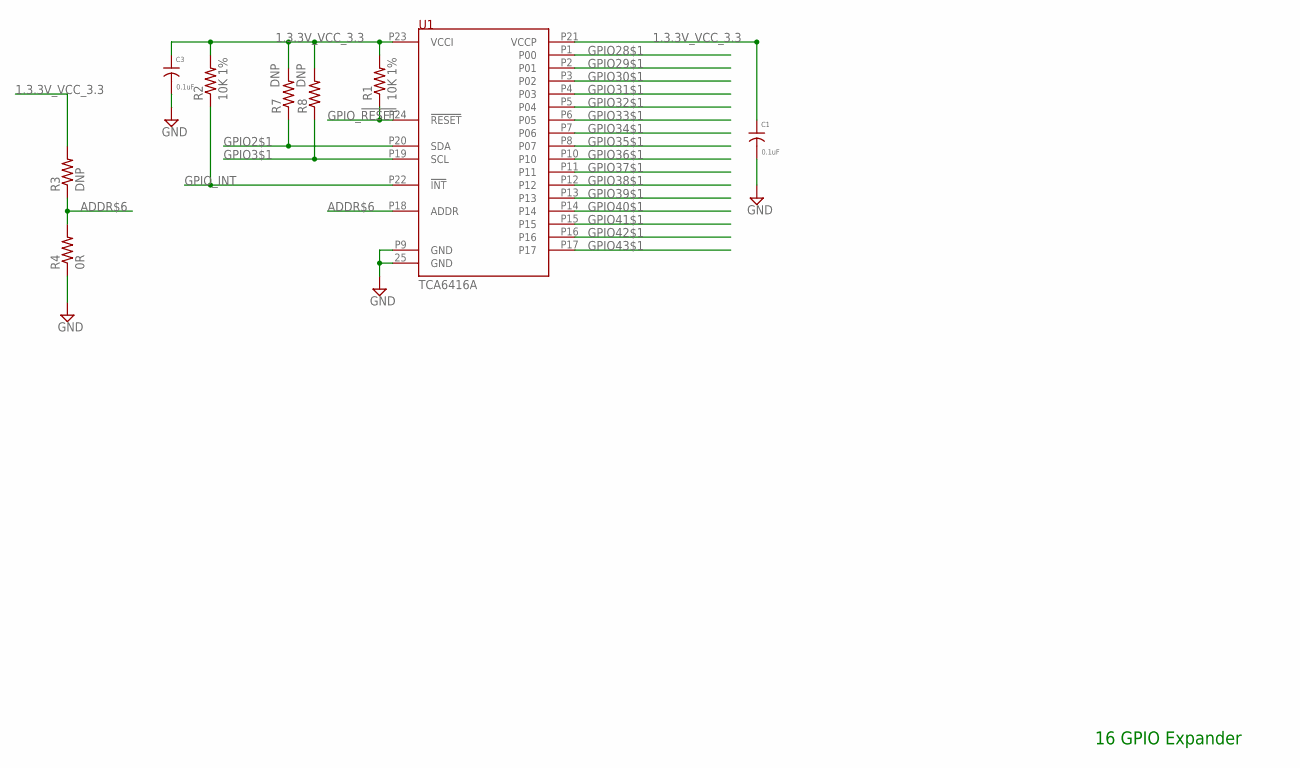
[picture p16: schematic PKG900000001464.sch, sheet 5]

Parts:
C1, C3: 0.1uF; 0201
R1, R2: 10K 1%; 0201
R3, R7, R8: DNP; 0201
R4: 0R; 0201
U1: TCA6416A; WQFN24

Connections:
1.3.3V_VCC_3.3: C1.1, C3.1, R1.2, R2.2, R3.2, R7.2, R8.2, U1.P21 (VCCP), U1.P23 (VCCI); also elsewhere on the board
ADDR$6: R3.1, R4.2, U1.P18 (ADDR)
GND: C1.2, C3.2, R4.1, U1.25 (GND), U1.P9 (GND); also elsewhere on the board
GPIO2$1: R7.1, U1.P20 (SDA); also elsewhere on the board
GPIO3$1: R8.1, U1.P19 (SCL); also elsewhere on the board
GPIO28$1: U1.P1 (P00); also elsewhere on the board
GPIO29$1: U1.P2 (P01); also elsewhere on the board
GPIO30$1: U1.P3 (P02); also elsewhere on the board
GPIO31$1: U1.P4 (P03); also elsewhere on the board
GPIO32$1: U1.P5 (P04); also elsewhere on the board
GPIO33$1: U1.P6 (P05); also elsewhere on the board
GPIO34$1: U1.P7 (P06); also elsewhere on the board
GPIO35$1: U1.P8 (P07); also elsewhere on the board
GPIO36$1: U1.P10; also elsewhere on the board
GPIO37$1: U1.P11; also elsewhere on the board
GPIO38$1: U1.P12; also elsewhere on the board
GPIO39$1: U1.P13; also elsewhere on the board
GPIO40$1: U1.P14; also elsewhere on the board
GPIO41$1: U1.P15; also elsewhere on the board
GPIO42$1: U1.P16; also elsewhere on the board
GPIO43$1: U1.P17; also elsewhere on the board
GPIO_!RESET: R1.1, U1.P24 (!RESET!)
GPIO_INT: R2.1, U1.P22 (!INT!)

Notes on the sheet:
16 GPIO Expander

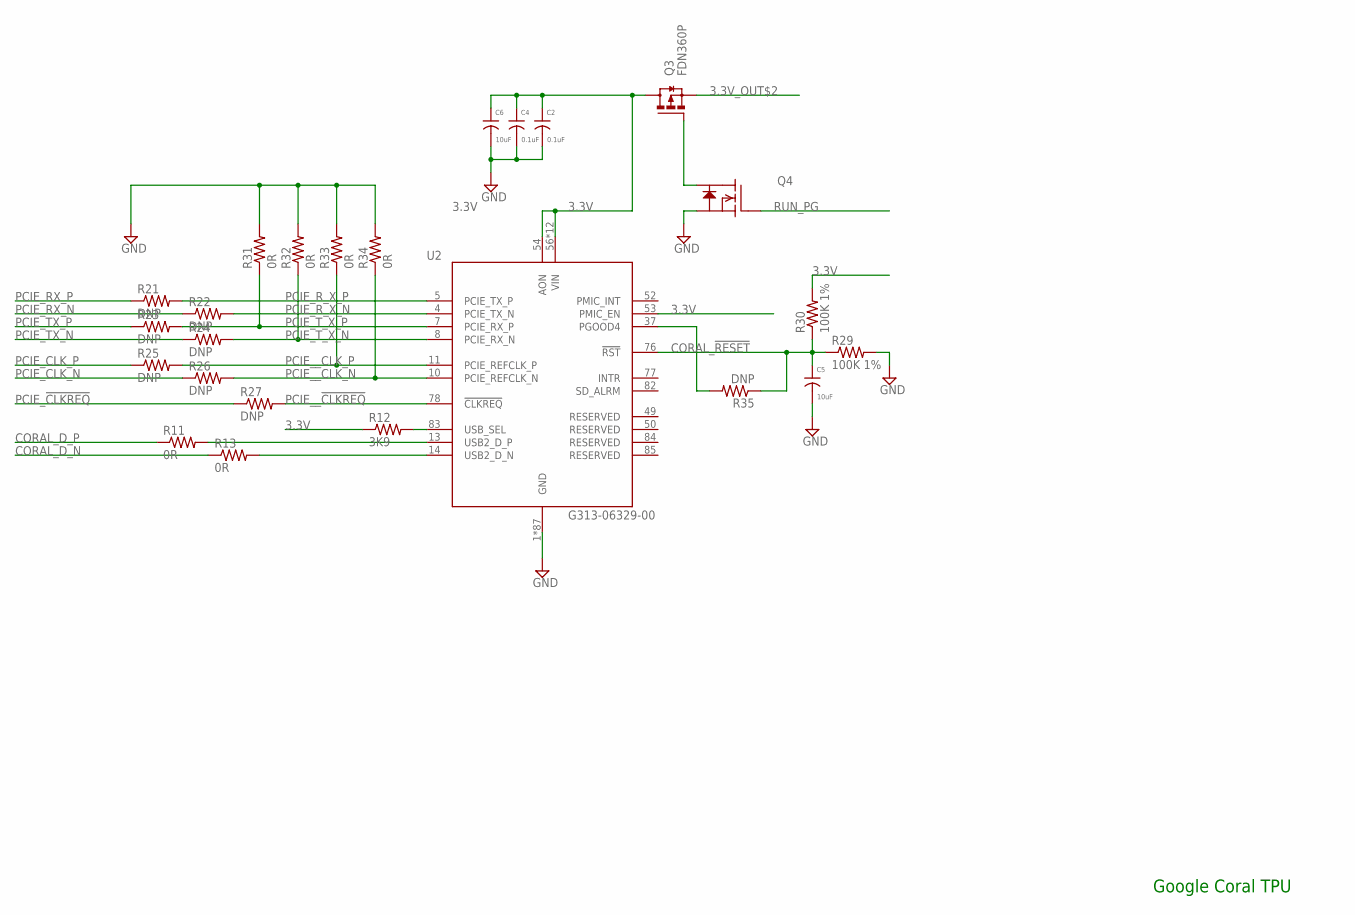
[picture p17: schematic PKG900000001464.sch, sheet 6]

Parts:
C2, C4: 0.1uF; 0201
C5, C6: 10uF; 0603
Q3: FDN360P; SOT23
Q4: BSS138; SOT23
R11, R13, R31, R32, R33, R34: 0R; 0201
R12: 3K9; 0201
R21, R22, R23, R24, R25, R26, R27, R35: DNP; 0201
R29, R30: 100K 1%; 0201
U2: G313-06329-00

Connections:
3.3V: C2.1, C4.1, C6.1, Q3.3 (D), R12.1, R30.2, U2.53 (PMIC_EN), U2.54 (AON), U2.56 (VIN), U2.57 (VIN), U2.58 (VIN), U2.59 (VIN), U2.60 (VIN), U2.61 (VIN), U2.62 (VIN), U2.63 (VIN), U2.64 (VIN), U2.65 (VIN), U2.66 (VIN), U2.67 (VIN); also elsewhere on the board
3.3V_OUT$2: Q3.2 (S); also elsewhere on the board
CORAL_!RESET: C5.1, R29.1, R30.1, R35.1, U2.76 (!RST)
CORAL_D_N: R13.1; also elsewhere on the board
CORAL_D_P: R11.1; also elsewhere on the board
CORAL_USB_SELECT: R12.2, U2.83 (USB_SEL)
CORAL__D_N: R13.2, U2.14 (USB2_D_N)
CORAL__D_P: R11.2, U2.13 (USB2_D_P)
FET_ENABLES: Q3.1 (G), Q4.3 (D)
GND: C2.2, C4.2, C5.2, C6.2, Q4.2 (S), R29.2, R31.2, R32.2, R33.2, R34.2, U2.1 (GND), U2.2 (GND), U2.3 (GND), U2.6 (GND), U2.9 (GND), U2.12 (GND), U2.15 (GND), U2.16 (GND), U2.17 (GND), U2.18 (GND), U2.19 (GND), U2.20 (GND), U2.21 (GND), U2.22 (GND), U2.23 (GND), U2.24 (GND), U2.25 (GND), U2.26 (GND), U2.27 (GND), U2.28 (GND), U2.29 (GND), U2.30 (GND), U2.31 (GND), U2.32 (GND), U2.33 (GND), U2.34 (GND), U2.35 (GND), U2.36 (GND), U2.38 (GND), U2.39 (GND), U2.40 (GND), U2.41 (GND), U2.42 (GND), U2.43 (GND), U2.44 (GND), U2.45 (GND), U2.46 (GND), U2.47 (GND), U2.48 (GND), U2.51 (GND), U2.55 (GND), U2.68 (GND), U2.69 (GND), U2.70 (GND), U2.71 (GND), U2.72 (GND), U2.73 (GND), U2.74 (GND), U2.75 (GND), U2.79 (GND), U2.80 (GND), U2.81 (GND), U2.86 (GND), U2.87 (GND), U2.88 (GND), U2.89 (GND), U2.90 (GND), U2.91 (GND), U2.92 (GND), U2.93 (GND), U2.94 (GND), U2.95 (GND), U2.96 (GND), U2.97 (GND), U2.98 (GND), U2.99 (GND), U2.100 (GND), U2.101 (GND), U2.102 (GND), U2.103 (GND), U2.104 (GND), U2.105 (GND), U2.106 (GND), U2.107 (GND), U2.108 (GND), U2.109 (GND), U2.110 (GND), U2.111 (GND), U2.112 (GND), U2.113 (GND), U2.114 (GND), U2.115 (GND), U2.116 (GND), U2.117 (GND), U2.118 (GND), U2.119 (GND), U2.120 (GND); also elsewhere on the board
PCIE_!CLKREQ: R27.1; also elsewhere on the board
PCIE_CLK_N: R26.1; also elsewhere on the board
PCIE_CLK_P: R25.1; also elsewhere on the board
PCIE_RX_N: R22.1; also elsewhere on the board
PCIE_RX_P: R21.1; also elsewhere on the board
PCIE_R_X_N: R22.2, U2.4 (PCIE_TX_N)
PCIE_R_X_P: R21.2, U2.5 (PCIE_TX_P)
PCIE_TX_N: R24.1; also elsewhere on the board
PCIE_TX_P: R23.1; also elsewhere on the board
PCIE_T_X_N: R24.2, R32.1, U2.8 (PCIE_RX_N)
PCIE_T_X_P: R23.2, R31.1, U2.7 (PCIE_RX_P)
PCIE__!CLKREQ: R27.2, U2.78 (!CLKREQ)
PCIE__CLK_N: R26.2, R34.1, U2.10 (PCIE_REFCLK_N)
PCIE__CLK_P: R25.2, R33.1, U2.11 (PCIE_REFCLK_P)
PGOOD4$: R35.2, U2.37 (PGOOD4)
RUN_PG: Q4.1 (G); also elsewhere on the board

Notes on the sheet:
Google Coral TPU

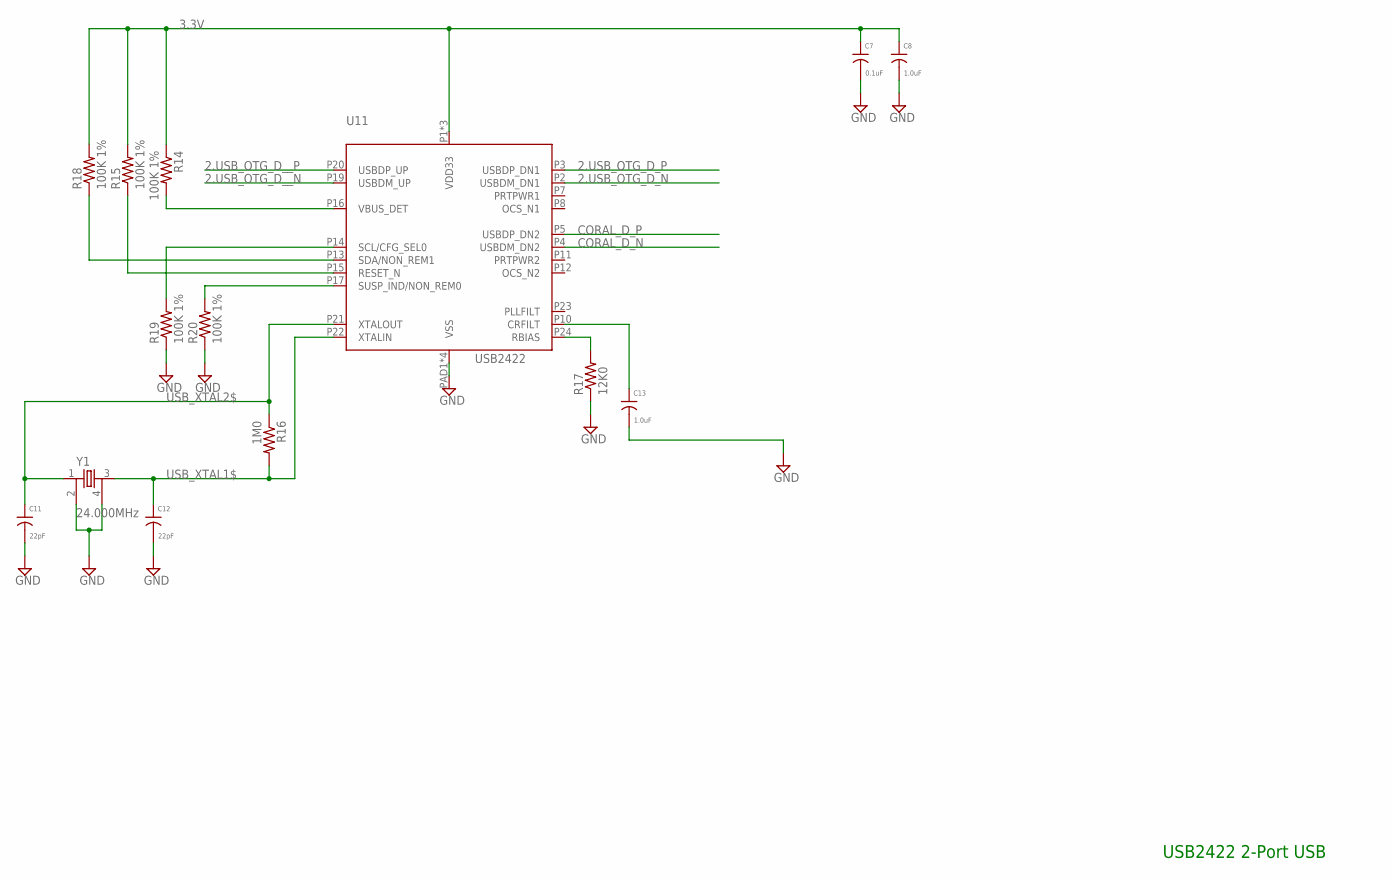
[picture p18: schematic PKG900000001464.sch, sheet 7]

Parts:
C7: 0.1uF; 0201
C8, C13: 1.0uF; 0402
C11, C12: 22pF; 0201
R14, R15, R18, R19, R20: 100K 1%; 0201
R16: 1M0; 0201
R17: 12K0; 0201
U11: USB2422; VQFN24
Y1: 24.000MHz; CRYSTAL-3225

Connections:
2.USB_OTG_D_N: U11.P2 (USBDM_DN1); also elsewhere on the board
2.USB_OTG_D_P: U11.P3 (USBDP_DN1); also elsewhere on the board
2.USB_OTG_D__N: U11.P19 (USBDM_UP); also elsewhere on the board
2.USB_OTG_D__P: U11.P20 (USBDP_UP); also elsewhere on the board
3.3V: C7.1, C8.1, R14.1, R15.2, R18.2, U11.P1 (VDD33), U11.P9 (VDD33), U11.P18 (VDD33); also elsewhere on the board
CORAL_D_N: U11.P4 (USBDM_DN2); also elsewhere on the board
CORAL_D_P: U11.P5 (USBDP_DN2); also elsewhere on the board
GND: C7.2, C8.2, C11.2, C12.2, C13.2, R17.1, R19.1, R20.1, U11.PAD1 (VSS), U11.PAD2 (VSS), U11.PAD3 (VSS), U11.PAD4 (VSS), Y1.2, Y1.4; also elsewhere on the board
HUB_CFG_SEL0: R19.2, U11.P14 (SCL/CFG_SEL0)
HUB_NON_REM0: R20.2, U11.P17 (SUSP_IND/NON_REM0)
HUB_NON_REM1: R18.1, U11.P13 (SDA/NON_REM1)
HUB_NRESET: R15.1, U11.P15 (RESET_N)
HUB_RBIAS: R17.2, U11.P24 (RBIAS)
USB_CRFILT$: C13.1, U11.P10 (CRFILT)
USB_XTAL1$: C12.1, R16.2, U11.P22 (XTALIN), Y1.3
USB_XTAL2$: C11.1, R16.1, U11.P21 (XTALOUT), Y1.1
VBUS_DET_HUB: R14.2, U11.P16 (VBUS_DET)

Notes on the sheet:
USB2422 2-Port USB
