gumstix/PKG900000001464/hardware/PKG900000001464.brd

## EAGLE design hardware/PKG900000001464.brd (continued)

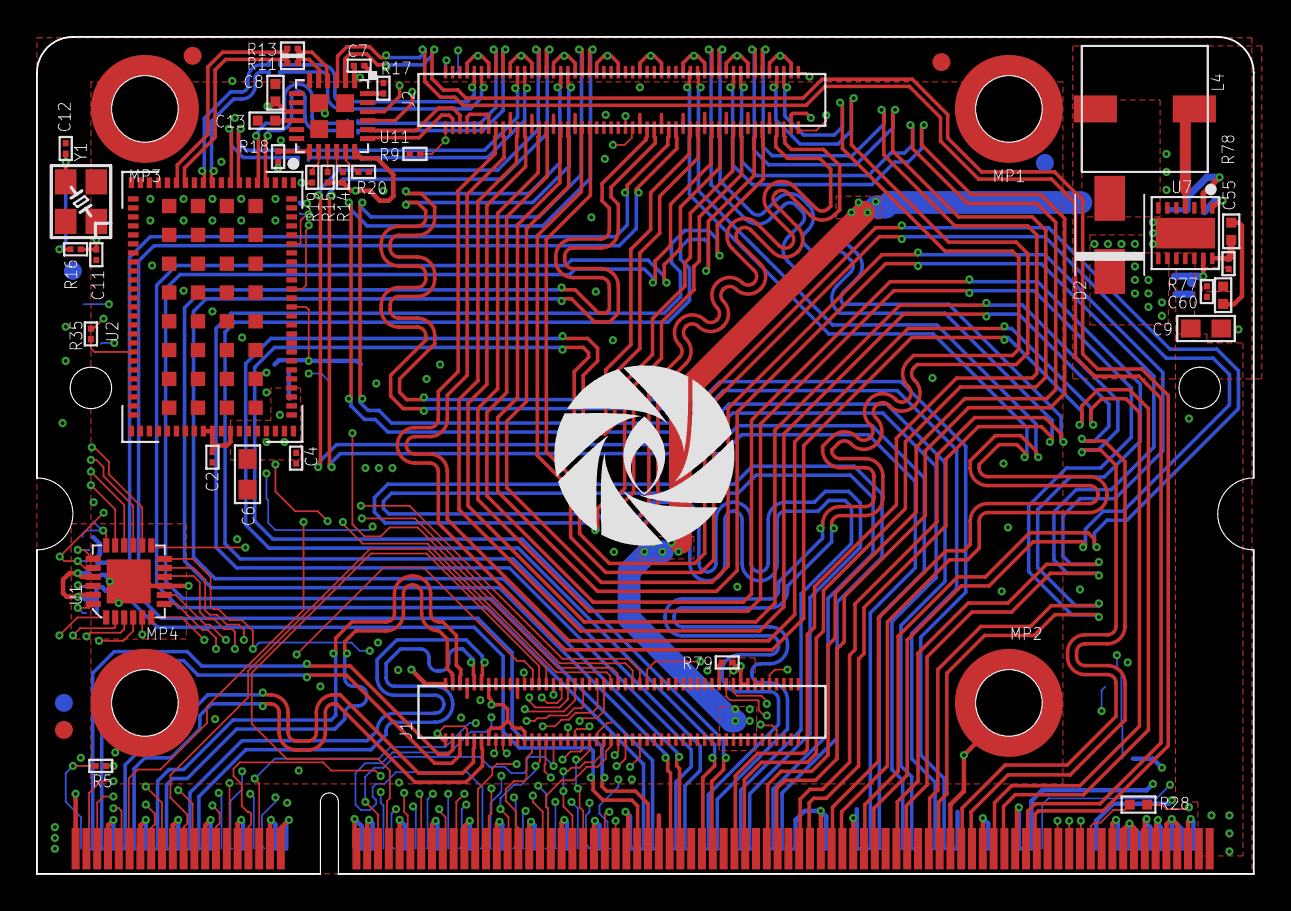
[picture p19: board PKG900000001464.brd from above]

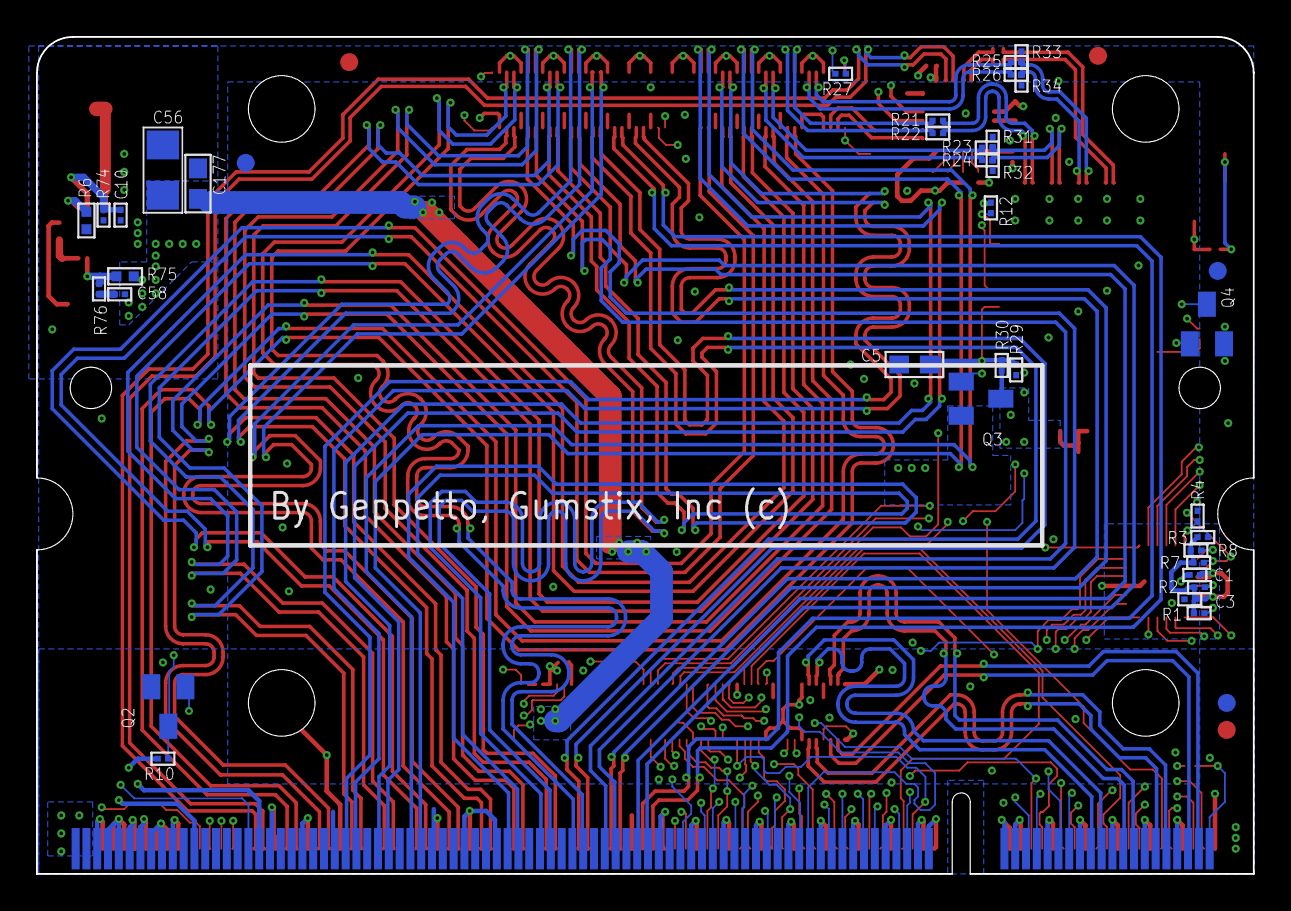
[picture p20: board PKG900000001464.brd from below]

Board: 6 copper layers, 67.6 x 46.5 mm, 84 parts (39 on the bottom side), 164 nets.
