gumstix/PKG900000001464/(notices)

Notices in the files:
parts and their libraries:
qualified_1: COMPANY_AND_YEAR: Geppetto, Gumstix Inc (c) 2019
